MaulikItaliya/Mixed-Signal-Board/Validation/DRC_Report.pdf

### Design Rules Verification Report

Filename : D:\Mixed_design_board\My data\Mixed_Design_Board.PcbDoc | Warnings 0

### Rule Violations 0

Warnings
Total | 0

Rule Violations
Clearance Constraint (Gap=0.1mm) (All),(All) | 0
Clearance Constraint (Gap=1mm) (InNet('EARTH')),(InNet('GND')) | 0
Clearance Constraint (Gap=1mm) (InNet('EARTH')),(InNet('NetC21_2')) | 0
Short-Circuit Constraint (Allowed=No) (All),(All) | 0
Un-Routed Net Constraint ( (All) ) | 0
Modified Polygon (Allow modified: No), (Allow shelved: No) | 0
Width Constraint (Min=0.1mm) (Max=1mm) (Preferred=0.254mm) (All) | 0
Width Constraint (Min=0.3mm) (Max=1mm) (Preferred=0.3mm) (InNet('GND')) | 0
Width Constraint (Min=0.3mm) (Max=1mm) (Preferred=0.3mm) (InNet('+3V3')) | 0
Routing TopologyRule(Topology=Shortest) (All) | 0
Power Plane Connect Rule(Relief Connect )(Expansion=0.508mm) (Conductor Width=0.254mm) (Air Gap=0.254mm) | 0
Hole Size Constraint (Min=0.025mm) (Max=5mm) (All) | 0
Hole To Hole Clearance (Gap=0.2mm) (All),(All) | 0
Silk to Silk (Clearance=0.1mm) (All),(All) | 0
Net Antennae (Tolerance=0mm) (All) | 0
Height Constraint (Min=0mm) (Max=25.4mm) (Prefered=12.7mm) (All) | 0
Total | 0
Sunday 11 Oct 2026 1:04:21 PM | Page 1 of 1
