MaulikItaliya/Mixed-Signal-Board/Documentation/PCB/Bottom_3D_View_PCB.PDF

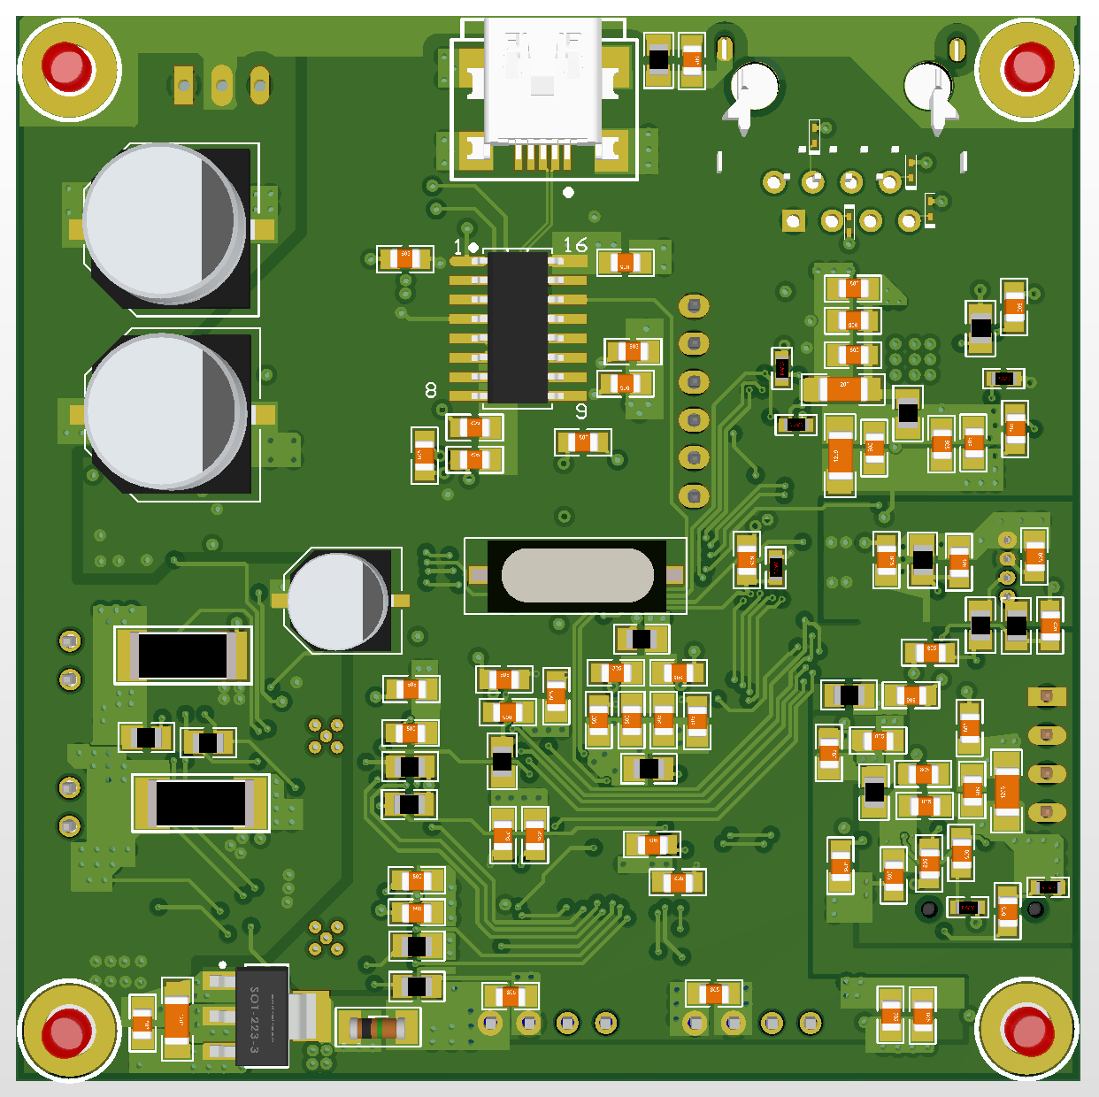
[picture p6: page 1]
