MaulikItaliya/Mixed-Signal-Board/Documentation/PCB/Top_View_3D_PCB.PDF

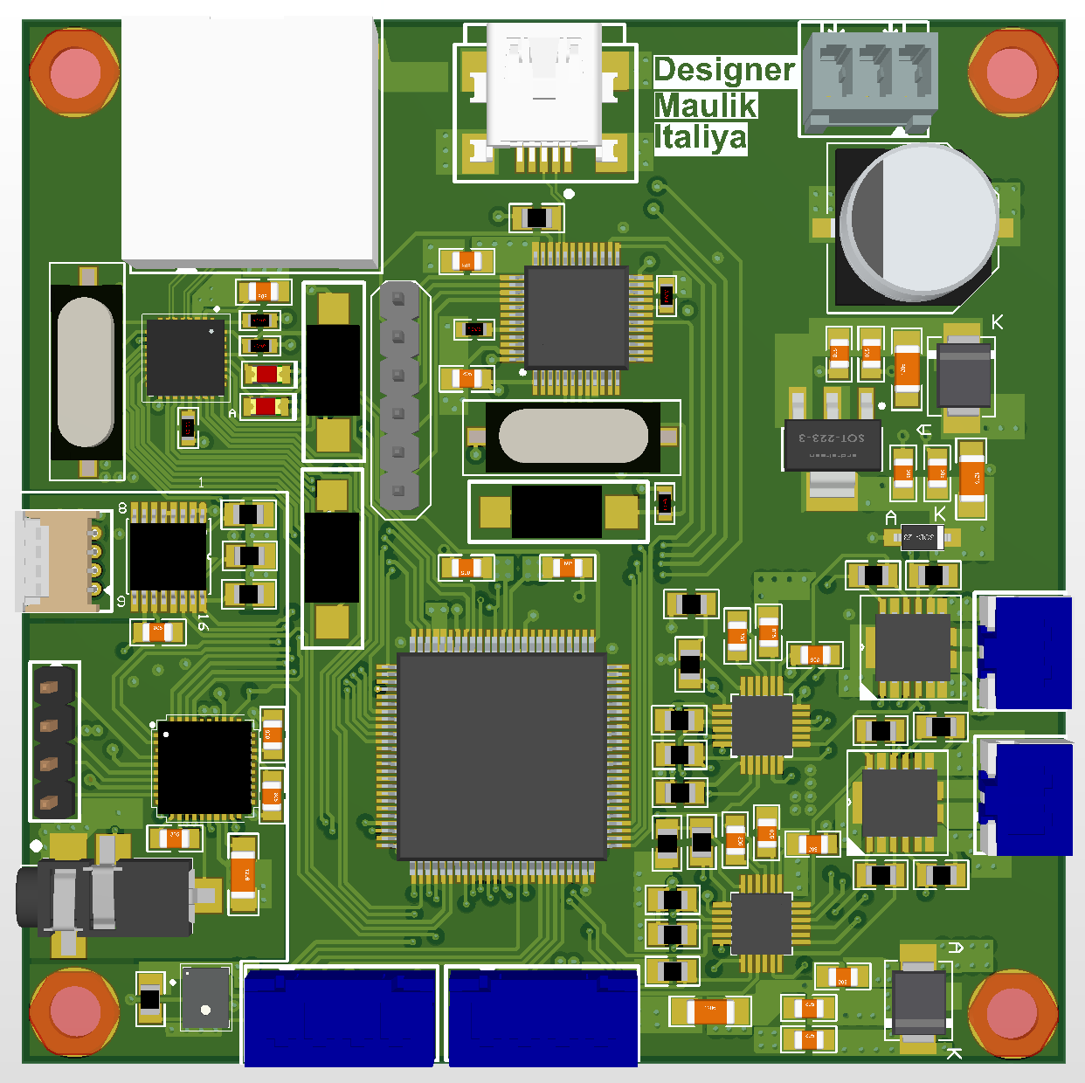
[picture p7: page 1]
