MaulikItaliya/Mixed-Signal-Board/BOM/Mixed_Design_Board_DigiKey__BOM.xlsx

Sheet: DigiKey BOM
MIXED DESIGN BOARD — DIGIKEY BOM
Designator | Value / Component | Quantity | Description | Package | Manufacturer | Manufacturer Part Number | DigiKey Part Number
C1, C59 | 4.7uF | 2 | 4.7µF ±10% 50V Ceramic Capacitor X5R 0805 (2012 Metric) | 0805 | Yageo | CC0805KKX5R9BB475 | 13-CC0805KKX5R9BB475CT-ND
C2, C3, C4, C9, C22, C25, C58, C72, C75 | 0.1uF | 9 | 0.1µF ±10% 50V Ceramic Capacitor X7R 0805 (2012 Metric) | 0805 | Samsung | CL21B104KBFNNNE | 1276-1180-1-ND
C5, C6, C55, C56 | 30pF | 4 | ±10% 50V Ceramic Capacitor C0G, NP0 0805 (2012 Metric) | 0805 | KEMET | C0805C300K5GACTU | 399-C0805C300K5GACTUCT-ND
C7, C12, C18, C23, C26, C27, C36, C40, C41, C42, C51, C52, C67, C68, C73, C76, C77, C82, C85, C88, C91 | 1uF | 21 | 1µF ±5% 50V Ceramic Capacitor X7R 0805 (2012 Metric) | 0805 | Samsung | CL21B105KAFNNNE | 1276-CL21B105KAFNNNECT-ND
C8, C14, C16, C21, C32, C33 | 10nF | 6 | 10000pF ±10% 50V Ceramic Capacitor X7R 0805 (2012 Metric) | 0805 | Samsung | CL21B103KBANNNC | 1276-1015-1-ND
C10 | 2nF | 1 | 2000pF ±10% 50V Ceramic Capacitor X7R 0805 (2012 Metric) | 0805 | Samsung Electro-Mechanics | CL21B202KBANNNC | 1276-CL21B202KBANNNCCT-ND
C11, C19, C45, C50, C83, C84, C89, C90 | 10uF | 8 | 10µF ±10% 50V Ceramic Capacitor X7R 1206 (3216 Metric) | 1206 | KEMET | C3216X7R1H106K160AB | 445-1445-1-ND
C13, C17, C28, C29, C30, C31, C34, C35, C37, C39, C44, C46, C47, C53, C54, C57, C60, C61, C62, C63, C64, C69, C70, C71, C81, C86, C87, C92 | 0.1uF | 28 | 0.1µF ±5% 50V Ceramic Capacitor X7R 0805 (2012 Metric) | 0805 | AVX Corporation | CL21B104KBFNNNE | 1276-1180-1-ND
C15, C20 | 20pF | 2 | ±10% 50V Ceramic Capacitor C0G, NP0 0805 (2012 Metric) | 0805 | AVX Corporation | 08055A200KAT2A | 478-08055A200KAT2ACT-ND
C24 | 100uF | 1 | 100µF 25V Aluminum Electrolytic Capacitors Radial, Can - SMD 1000 Hrs @ 105°C | Radial-SMD | Nichicon | UCM1E101MCL1GS | 493-14926-1-ND
C38, C43 | 22nF | 2 | 0.022µF ±10% 50V Ceramic Capacitor X7R 0805 (2012 Metric) | 0805 | Samsung Electro-Mechanics | CL21B223KBANNNC | 1276-1081-1-ND
C48, C49 | 150pF | 2 | 50V 150pF X7R ±10% 0805 Multilayer Ceramic Capacitors MLCC - SMD/SMT ROHS | 0805 | Yageo | CC0805KRX7R9BB151 | 13-CC0805KRX7R9BB151CT-ND
C65, C66 | 2.2uF | 2 | 2.2µF ±10% 25V Ceramic Capacitor X7R 0805 (2012 Metric) | 0805 | KEMET | C0805C225K3RACTU | 399-C0805C225K3RACTUCT-ND
C78, C79, C80 | 100uF | 3 | 100µF 50V Aluminum Polymer Capacitor Radial, Can - SMD 28mOhm 4000 Hrs @ 125°C | Radial-SMD | Nichicon | UHW1H101MPD | 493-XXXX-ND
D1, D2, D3, D4 | ESD3V3D9-TP | 4 | TVS DIODE 3.3V 8.8V SOD923 | SOD923 | Micro Commercial Co | ESD3V3D9-TP | ESD3V3D9-TPCT-ND
D5, D7 | MBRS130LT3G | 2 | Diode Schottky 30V 2A Surface Mount SMB | SMB | ON Semiconductor | MBRS130LT3G | MBRS130LT3GOSCT-ND
D6 | BZT52C3V3-7-F | 1 | Zener Diode 3.3V 500mW ±6% Surface Mount SOD-123 | SOD-123 | Diodes Incorporated | BZT52C3V3-7-F | BZT52C3V3-FDICT-ND
D8 | 3.3V ZENER | 1 | Zener Diode 3.3V 500mW ±5% Surface Mount LLDS; MiniMelf | SOD-80 | onsemi | MMSZ4684T1G | MMSZ4684T1GOSCT-ND
DS1, DS2 | RED LED | 2 | Red 631nm LED Indication - Discrete 2V 0805 (2012 Metric) | 0805 | Lite-On | LTST-C170KRKT | 160-1414-1-ND
FB1, FB2, FB3, FB4 | 1K | 4 | 1 kOhms @ 100MHz 1 Power Line Ferrite Bead 0805 (2012 Metric) 1.6A | 0805 | Laird | MI0805K400R-10 | 240-2398-1-ND
J1 | Bergstrip 2.54mm | 1 | 6 Pins, 1 Row 2.54mm Pitch, Straight bergstrip, Female | TH-CON | Molex | 22-05-7061 | WM4200-ND
J2, J5 | USB2.0 MINI B | 2 | USB - mini B USB 2.0 Receptacle Connector 5 Position Surface Mount, Right Angle | USB-MINI-B | EDAC | 690-005-299-043 | EDAC-690-005-299-043-ND
J3 | RJ45 LAN | 1 | 8 Pins, 2 Row 2.54mm Pitch, right angle Connector, male | TH-CON | Assmann WSW | A-2004-2-4-LP-N-R | AE9919-ND
J4, J10 | B2B-XH-A(LF)(SN) | 2 | 2 Pins, 1 Row 2.54mm Pitch, Straight Connector, male | TH-CON | JST | B2B-XH-A | 455-B2B-XH-A-ND
J6 | 1.25MM Spade 4PIN | 1 | 4 Pins, 1 Row 1.25mm Pitch, right angle Connector, male | TH-CON | JST | SM04B-SRSS-TB | 455-1804-1-ND
J7 | 4X1 STEREO | 1 | 2.50mm (0.094", 3/32", Sub Mini, Miniature) - Headphone Phone Jack Stereo (4 Conductor, TRRS) Connector Solder | SMD | CUI Devices | SJ-43514-SMT-TR | CP-43514SJCT-ND
J8, J9 | B4B-XH-A(LF)(SN) | 2 | 4 Pins, 1 Row 2.54mm Pitch, straight Connector, male | TH-CON | JST | B4B-XH-A | 455-B4B-XH-A-ND
J11 | Terminal Block 2.5mm | 1 | 3 Pins, 1 Row 2.54mm Pitch, straight Connector, male | TH-CON | Phoenix Contact | 1725656 | 277-1725656-ND
J12 | 4X1 BERG STRIP | 1 | 4 Pins, 1 Row 2.54mm Pitch, Straight bergstrip, Male | TH-CON | Würth Elektronik | 61300411121 | 732-5310-ND
MH1, MH2, MH3, MH4 | Mounting Hole | 4 | Mounting Hole | TH | NA | Not applicable — PCB mounting hole | Not applicable — PCB feature
Q1, Q2 | DMHT6016LFJ-13 | 2 | Mosfet Array 4 N-Channel 14.8A (Ta) Surface Mount V-DFN5045-12 | DFN5045-12 | ON Semiconductor | DMHT6016LFJ-13 | DMHT6016LFJ-13CT-ND
R1, R4 | 100K | 2 | 100 kOhms ±1% 0.1W, 1/10W Chip Resistor 0603 (1608 Metric) Automotive AEC-Q200 Thick Film | 0603 | Stackpole Electronics | RMCF0603FT100K | RMCF0603FT100KCT-ND
R2 | 1.5K | 1 | 1.5 kOhms ±1% 0.125W, 1/8W Chip Resistor 0805 (2012 Metric) Thick Film | 0805 | TE Connectivity | CRGH0805F1K5 | A126395CT-ND
R3, R7, R8, R9, R10, R36 | 10K | 6 | 10 kOhms ±1% 0.1W, 1/10W Chip Resistor 0603 (1608 Metric) Automotive AEC-Q200 Thick Film | 0603 | Walsin | WR06X1002FTL | 1292-WR06X1002FTLCT-ND
R5, R6 | 3K3 | 2 | 3.3 kOhms ±1% 0.1W, 1/10W Chip Resistor 0603 (1608 Metric) Automotive AEC-Q200 Thick Film | 0603 | Yageo | RC0603FR-073K3L | 311-3.30KHRCT-ND
R11 | 6.49K | 1 | 6.49 kOhms ±1% 0.125W, 1/8W Chip Resistor 0805 (2012 Metric) Moisture Resistant Thick Film | 0805 | Stackpole Electronics | RMCF0805FT6K49 | RMCF0805FT6K49CT-ND
R12 | 1M | 1 | 1 MOhms ±1% 0.125W, 1/8W Chip Resistor 0805 (2012 Metric) Automotive AEC-Q200 Thick Film | 0805 | Walsin | WR08X1004FTL | 1292-WR08X1004FTLCT-ND
R13, R37 | 2K | 2 | 2 kOhms ±1% 0.125W, 1/8W Chip Resistor 0805 (2012 Metric) Moisture Resistant Thick Film | 0805 | TE Connectivity | CRGH0805F2K0 | A126402CT-ND
R14, R38 | 3.3K | 2 | 3.3 kOhms ±1% 0.125W, 1/8W Chip Resistor 0805 (2012 Metric) Thick Film | 0805 | Panasonic | ERJ-6ENF3301V | P3.30KACT-ND
R15, R16, R17, R18, R21, R22, R23, R24, R25, R26, R31, R33, R39, R40, R41, R42, R45, R46, R47, R48 | 10K | 20 | 10 kOhms ±1% 0.125W, 1/8W Chip Resistor 0805 (2012 Metric) Automotive AEC-Q200 Thick Film | 0805 | Vishay | CRCW080510K0FKEA | 541-10.0KACT-ND
R19, R43 | 33K | 2 | Thick Film Resistors - SMD 33KOhms 1/8W 150V33 kOhms ±1% 0.125W, 1/8W Chip Resistor 0805 (2012 Metric) Thick Film | 0805 | Vishay | CRCW080533K0FKEA | 541-33.0KACT-ND
R20, R44 | 50mOHM | 2 | 50 mOhms ±1% 2W Chip Resistor 2512 (6432 Metric) Automotive AEC-Q200, Current Sense, Moisture Resistant Metal Element | 2512 | Yageo | PA2512FKF7W0R050E | YAG3594CT-ND
R27 | 100K | 1 | 100 kOhms ±1% 0.125W, 1/8W Chip Resistor 0805 (2012 Metric) Automotive AEC-Q200 Thick Film | 0805 | Walsin | WR08X1003FTL | 1292-WR08X1003FTLCT-ND
R28, R29 | 1K | 2 | 1 kOhms ±1% 0.125W, 1/8W Chip Resistor 0805 (2012 Metric) Moisture Resistant Thick Film | 0805 | Walsin | WR08X1001FTL | 1292-WR08X1001FTLCT-ND
R30, R32 | 51.1R | 2 | 51.1 Ohms ±1% 0.1W, 1/10W Chip Resistor 0603 (1608 Metric) Thick Film | 0603 | Vishay Dale | CRCW060351R1FKEA | 541-51.1HCT-ND
R34, R35 | 100R | 2 | 100 Ohms ±1% 0.125W, 1/8W Chip Resistor 0805 (2012 Metric) Automotive AEC-Q200, Pulse Withstanding Thick Film | 0805 | Walsin | WR08X1000FTL | 1292-WR08X1000FTLCT-ND
SW1, SW2, SW3 | TACTILE SWITCH | 3 | Tactile Switch SPST-NO Top Actuated Surface Mount | SMD | C&K | KMR2 | CKN10298CT-ND
U1 | STM32F103C8T6 | 1 | ARM® Cortex®-M3 STM32F1 Microcontroller IC 32-Bit 72MHz 64KB (64K x 8) FLASH 48-LQFP (7x7) | LQFP48 | STMicroelectronics | STM32F103C8T6 | 497-6063-ND
U2 | DP83826IRHBR | 1 | Ethernet ICs Low latency 10/100-Mbps PHY, MII interface and enhanced mode with an industrial temperature range 32-VQFN -40 to 85 | 32-VQFN | Texas Instruments | DP83826IRHBR | 296-DP83826IRHBRCT-ND
U3, U9 | DRV8701ERGET | 2 | Motor Driver Power MOSFET Parallel 24-VQFN (4x4) | VFQFN24 | Texas Instruments | DRV8701ERGET | 296-DRV8701ERGETCT-ND
U4 | CH340C | 1 | USB Bridge, USB to UART USB 2.0 UART Interface | SOIC16 | Olimex | CH340C | CH340C-ND
U5 | ADS122C04IPW | 1 | 24 Bit Analog to Digital Converter 4 Input 1 Sigma-Delta 16-TSSOP | TSSOP16 | Texas Instruments | ADS122C04IPW | 296-49069-ND
U6 | CS43L22-CNZ | 1 | Audio D/A Converter ICs Low Power Stereo DAC w/ClassD Spkr Driver | QFN-40 | Cirrus Logic | CS43L22-CNZ | 598-1650-ND
U7 | IMP34DT05TR | 1 | MEMS Microphones AUTO & INDUSTRIAL SENSORS | HCLGA-4 | STMicroelectronics | IMP34DT05TR | 497-18183-1-ND
U8 | STM32F407VGT6 | 1 | ARM® Cortex®-M4 STM32F4 Microcontroller IC 32-Bit 168MHz 1MB (1M x 8) FLASH 100-LQFP (14x14) | LQFP100 | STMicroelectronics | STM32F407VGT6 | 497-11605-ND
U10, U11 | LD1117S33CTR | 2 | Linear Voltage Regulator IC 1 Output 800mA SOT-223 | SOT223 | STMicroelectronics | LD1117S33CTR | 497-1241-1-ND
X1, X2 | 8Mhz | 2 | 8MHz ±30ppm Crystal 32pF 60 Ohms HC-49/US | SMD/SMT | ECS Inc. | ECS-80-32-5PX-TR | XC1970CT-ND
Y1 | 25Mhz -14mm | 1 | 25MHz ±30ppm Crystal 20pF 30 Ohms HC-49/US | SMD | Fox Electronics | FOXSDLF/250F-20 | 535-FOXSDLF/250F-20CT-ND

Sheet: Pricing Notes
PRICING NOTES
Why unit prices are blank | DigiKey pricing depends on current stock, package/reel choice, order quantity, and live price breaks. I did not invent prices. Enter the current DigiKey Germany price in the Unit Price (EUR) column; line totals and the BOM total calculate automatically.
How to get a reliable quote | Upload the BOM into DigiKey My Lists, confirm each exact DigiKey part number and quantity, then use the quote function to lock pricing. DigiKey says quotes can secure pricing for 30 days.
Engineering check | The current part numbers in the workbook still need validation against the schematic, package, electrical ratings, and live DigiKey listing before purchase.
