MaulikItaliya/Mixed-Signal-Board/Documentation/Schematic/Mixed-Signal-Embedded-Board-Schematic.PDF

JTAG/SWD | STM32F103

## DAC & MIC

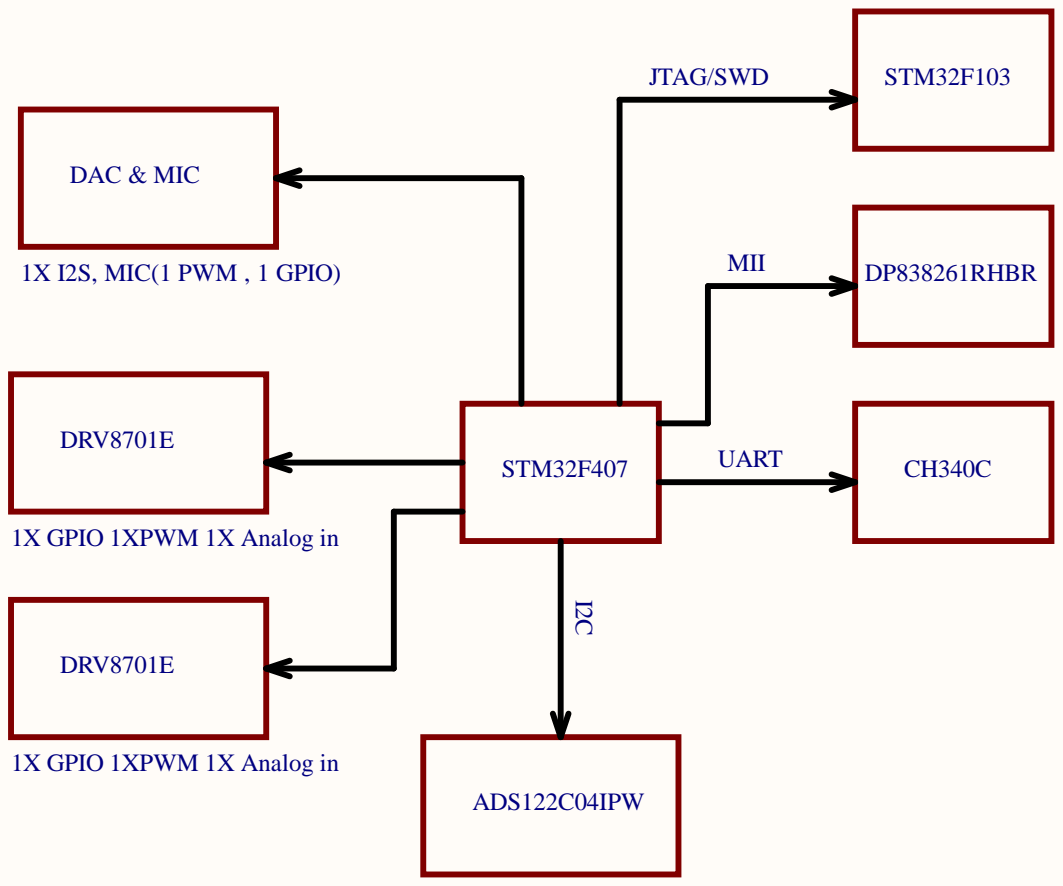
[picture p8: page 1]
File:; STM32F407; DP838261RHBR I; CH340C UART; ADS122C04IPW; DRV8701E

1X I2S, MIC(1 PWM , 1 GPIO)

1X GPIO 1XPWM 1X Analog in

STM32F407 Mixed-Signal Hardware Design
Title

Size: A4 | Number: MSD-001 | Sheet 1 of 11 Revision: V1.0

Date: 06-10-2026 Time: 21:29:24 | | Designer Maulik Italiya

D:\Mixed_design_board\My data\Schematic Blocks.SchDoc

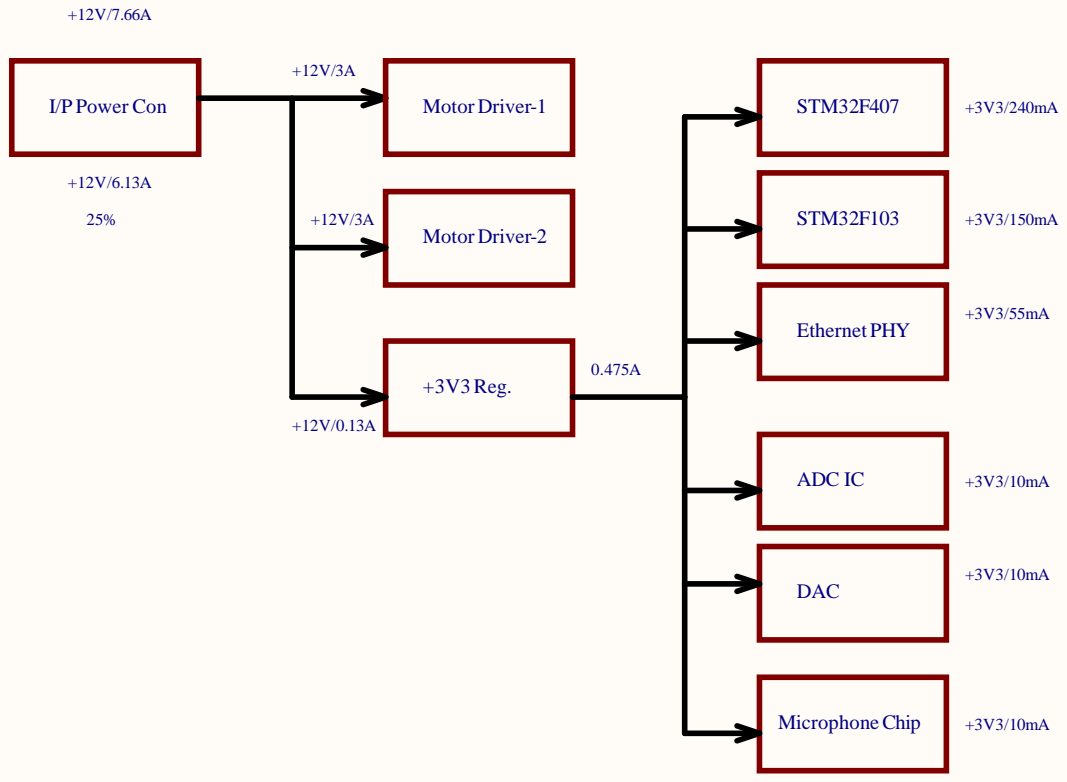
[picture p9: page 2]
File:; I/P Power Con; Motor Driver-1; Motor Driver-2; +3V3Reg.; STM32F407; STM32F103; Ethernet PHY; ADC IC; DAC; MicrophoneChip

STM32F407 Mixed-Signal Hardware Design
Title

Size: A4 | Number: MSD-001 | Sheet 2 of 11 Revision: V1.0

Date: 06-10-2026 Time: 21:29:24 | | Designer Maulik Italiya

D:\Mixed_design_board\My data\Power Budget.SchDoc

R1 100

ST

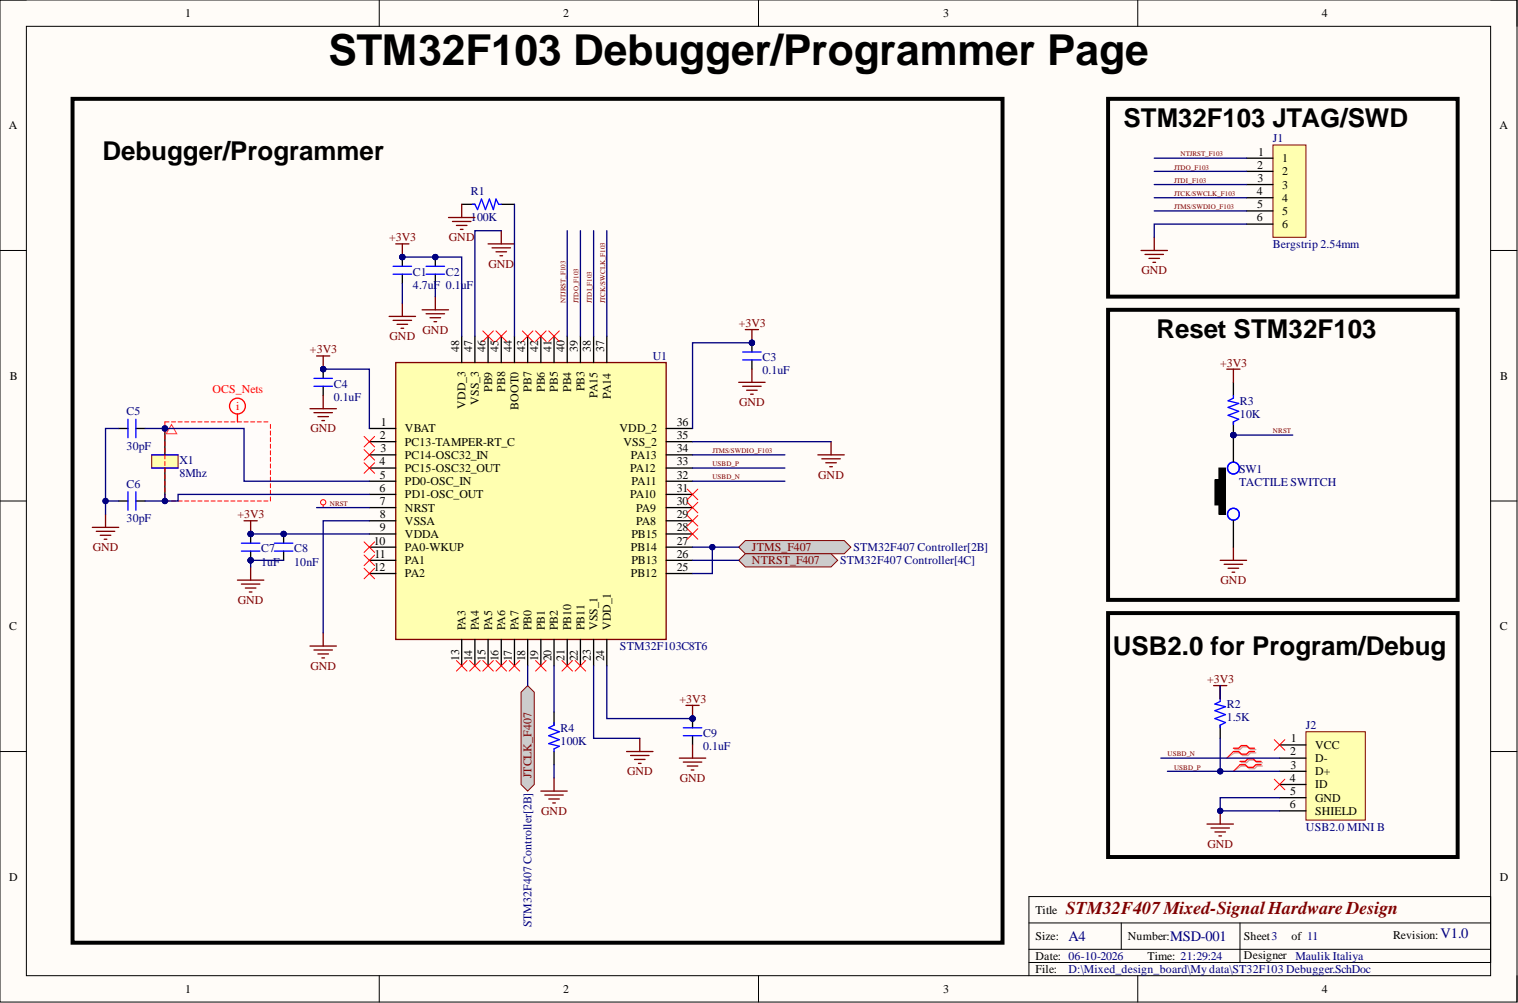
[picture p10: page 3]

Size A | N umb er M SD-1 | Shee t f Rev s V1 .

Dat e -T ime : | | Des er Mau k Ital y a

Ethernet PHY | ETH Reset an

# d Fault LEDs

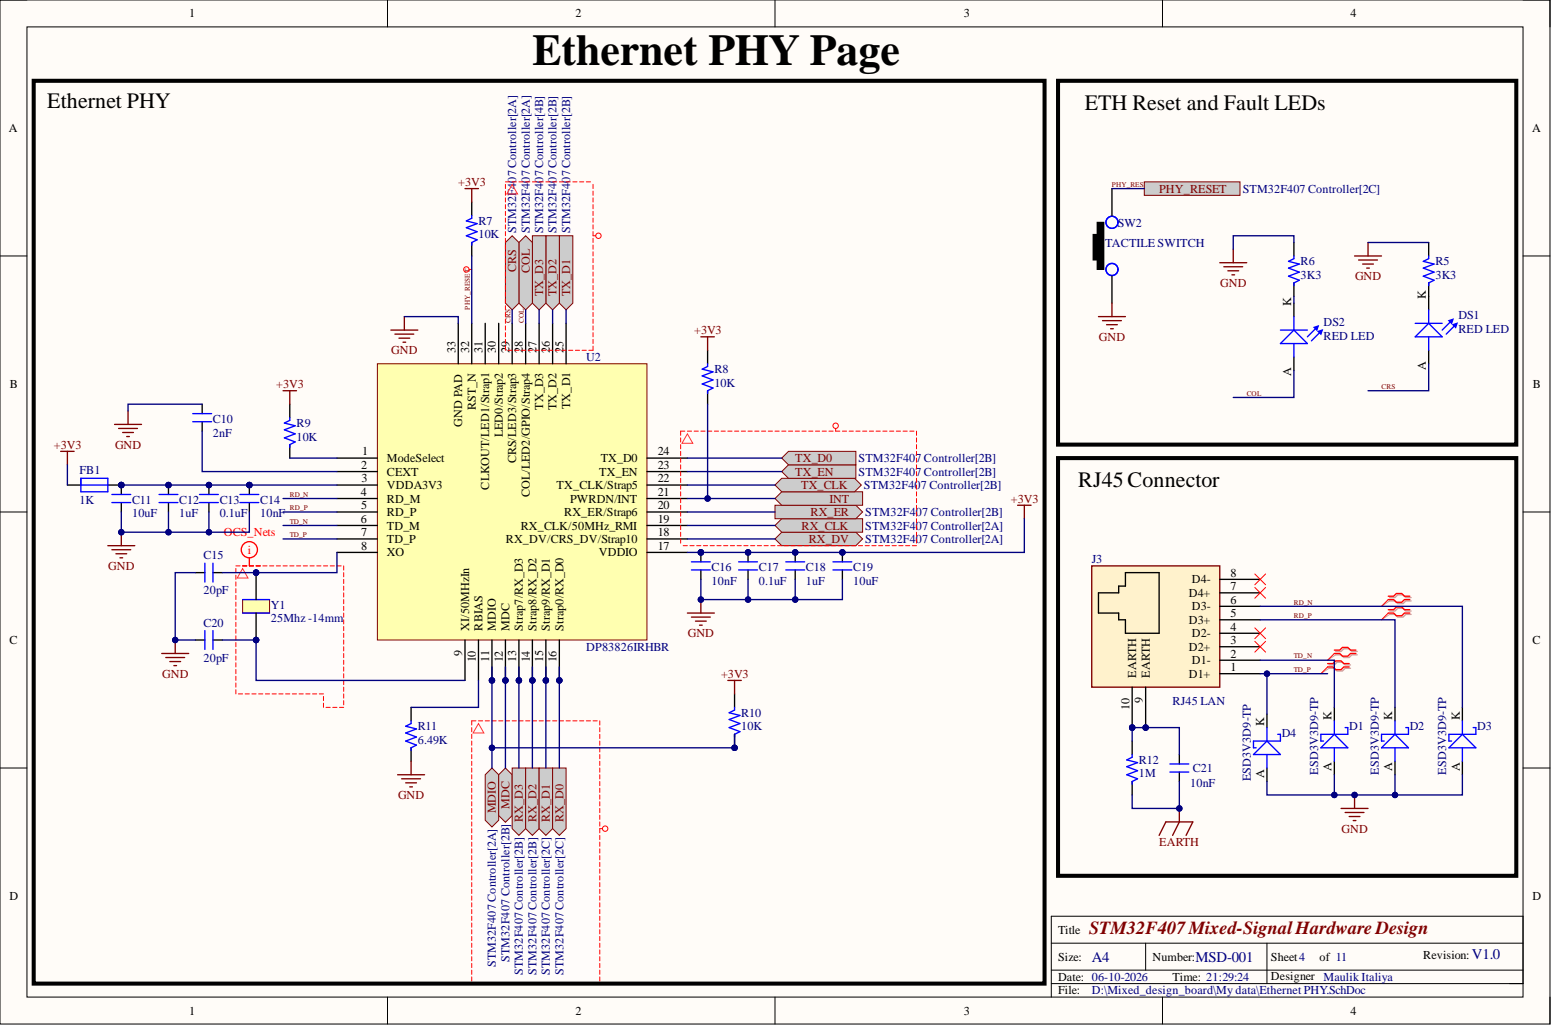
[picture p11: page 4]

# Motor Driver DRV8

7

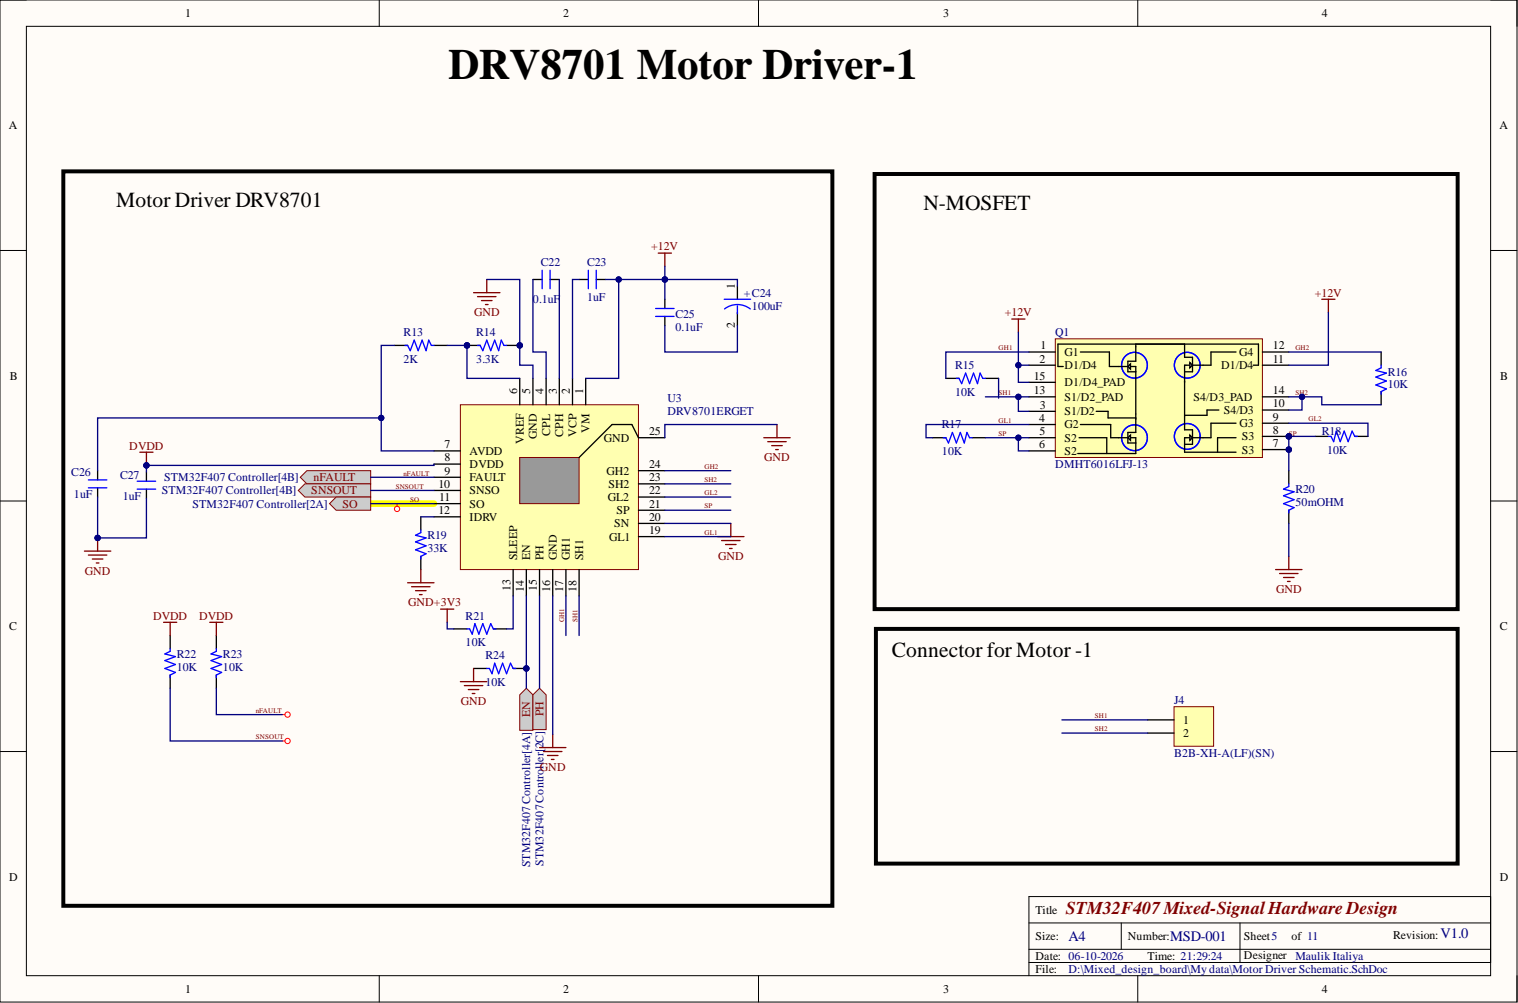
[picture p12: page 5]
STM3 2F4; Mixed-Signal Hardware Desig n; data\Mo; Dri; ver Schemat; SLEEP 13 EN 14 PH 15; GND 16 GH1 17 SH1 18; 24 GND; STM3; tro; ler[; SNSO; ler; nFA; EN STM32F407Controller[4A]; PH STM32F407Controller[2C] G; 4 S1/D2_PAD; DMH; SPGL; N-MOSFET; DRV8701 Motor Driver-1

VM 1 VCP 2 CPH 3 CPL 4 GND 5 VREF 6

nector for Motor -1

CH3

4

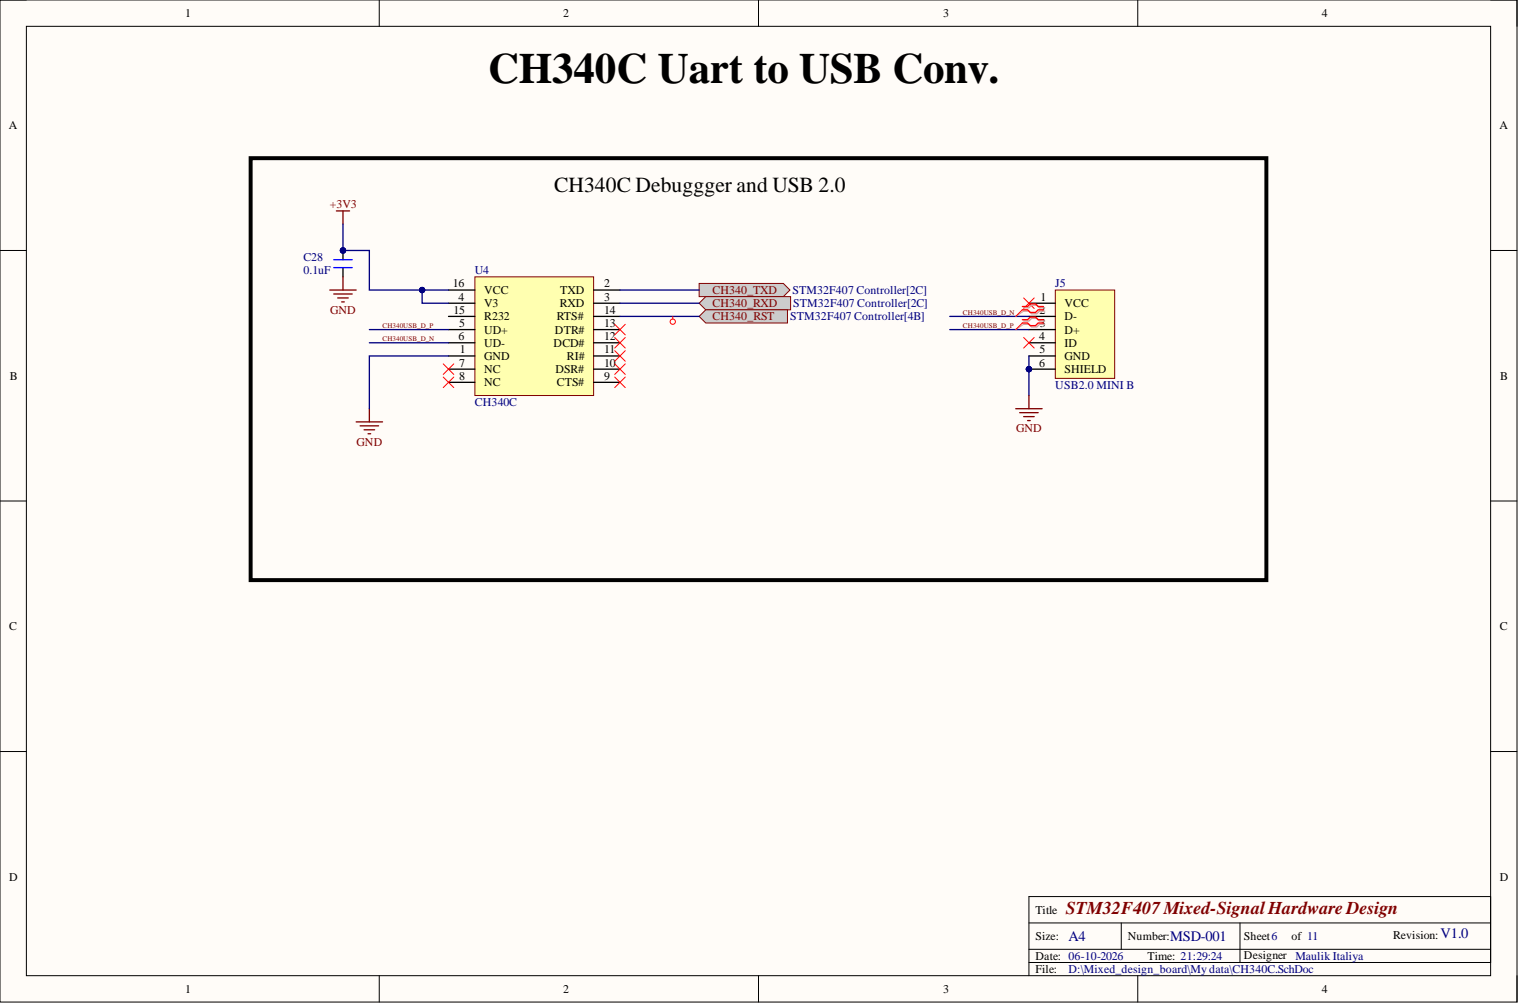
[picture p13: page 6]
STM3 2F4; Mixed-Signal Hardware Desig n; data\CH; DSR#; DCD; RTS#; VCC; H340USB_D_P; H340USB_D; STM3; tro; ler[; SHIE; 5USB2.0 MINI; 0C Deb; ger an; d USB

CH340C Uart to USB Conv

2

# 4 Bit ADC Chip

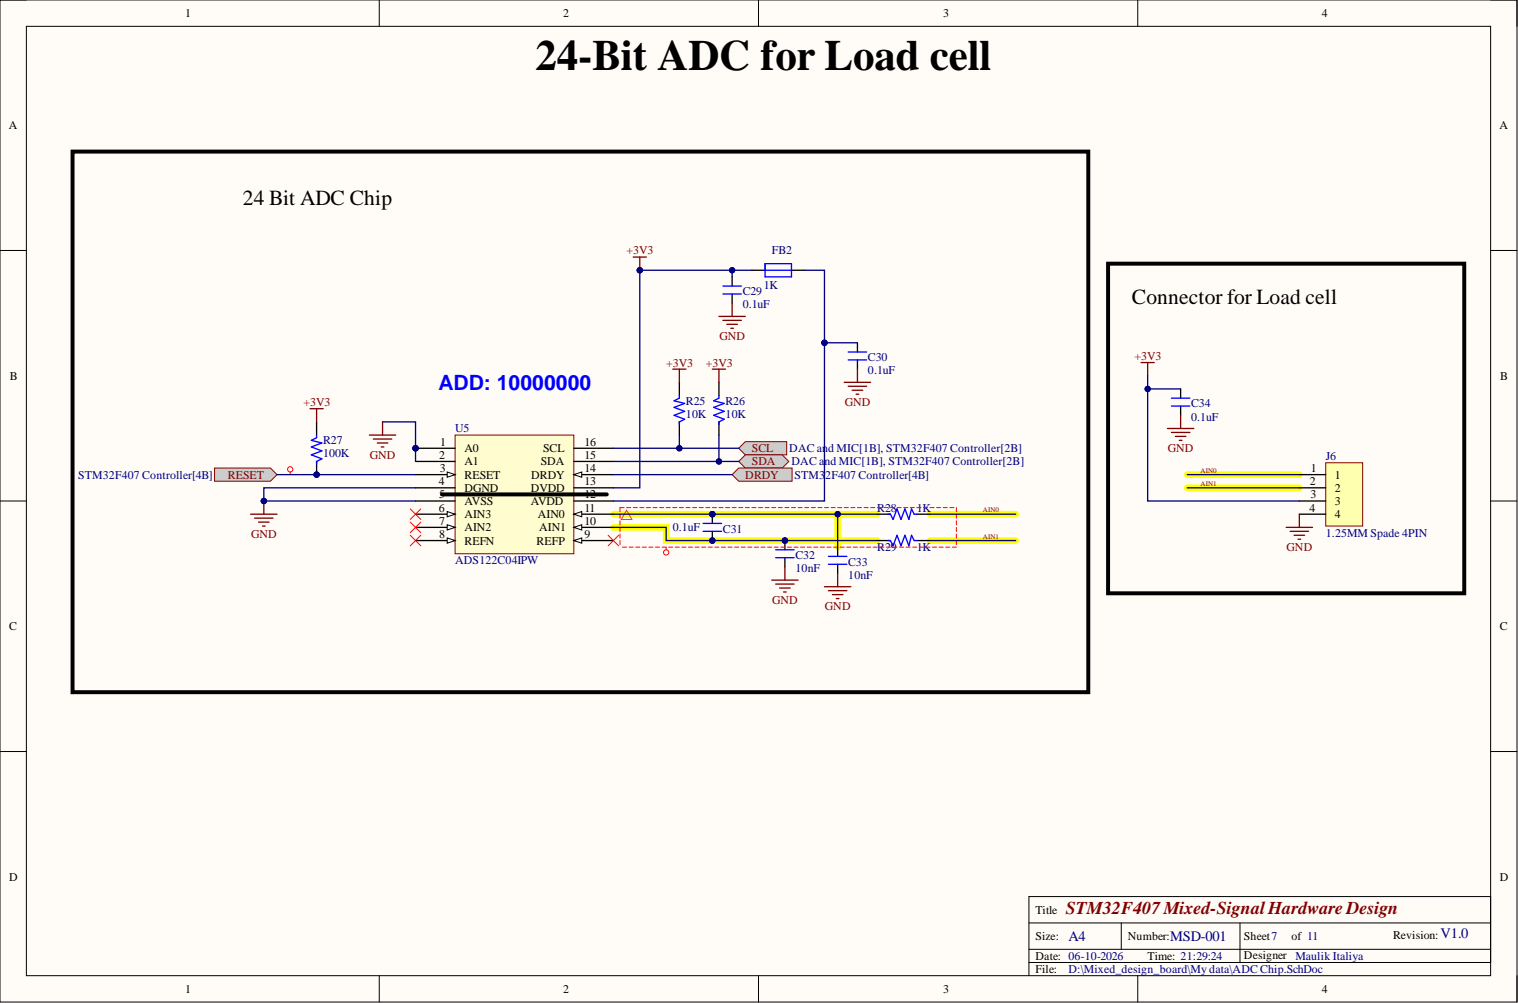
[picture p14: page 7]
STM3 2F4; Mixed-Signal Hardware Desig n; data\; RESE; AIN; REFP; DRD; 4 SDA; 15 SCL; IPW; STM3; tro; ler[; SCL; d MIC[1B], STM3; ler[2B]; 5MM Spade; 4PIN; ADD: 10000000; 24-Bit ADC

for Load cell

nector for Load cell

# ADD: 10010100

# DAC For Stereo

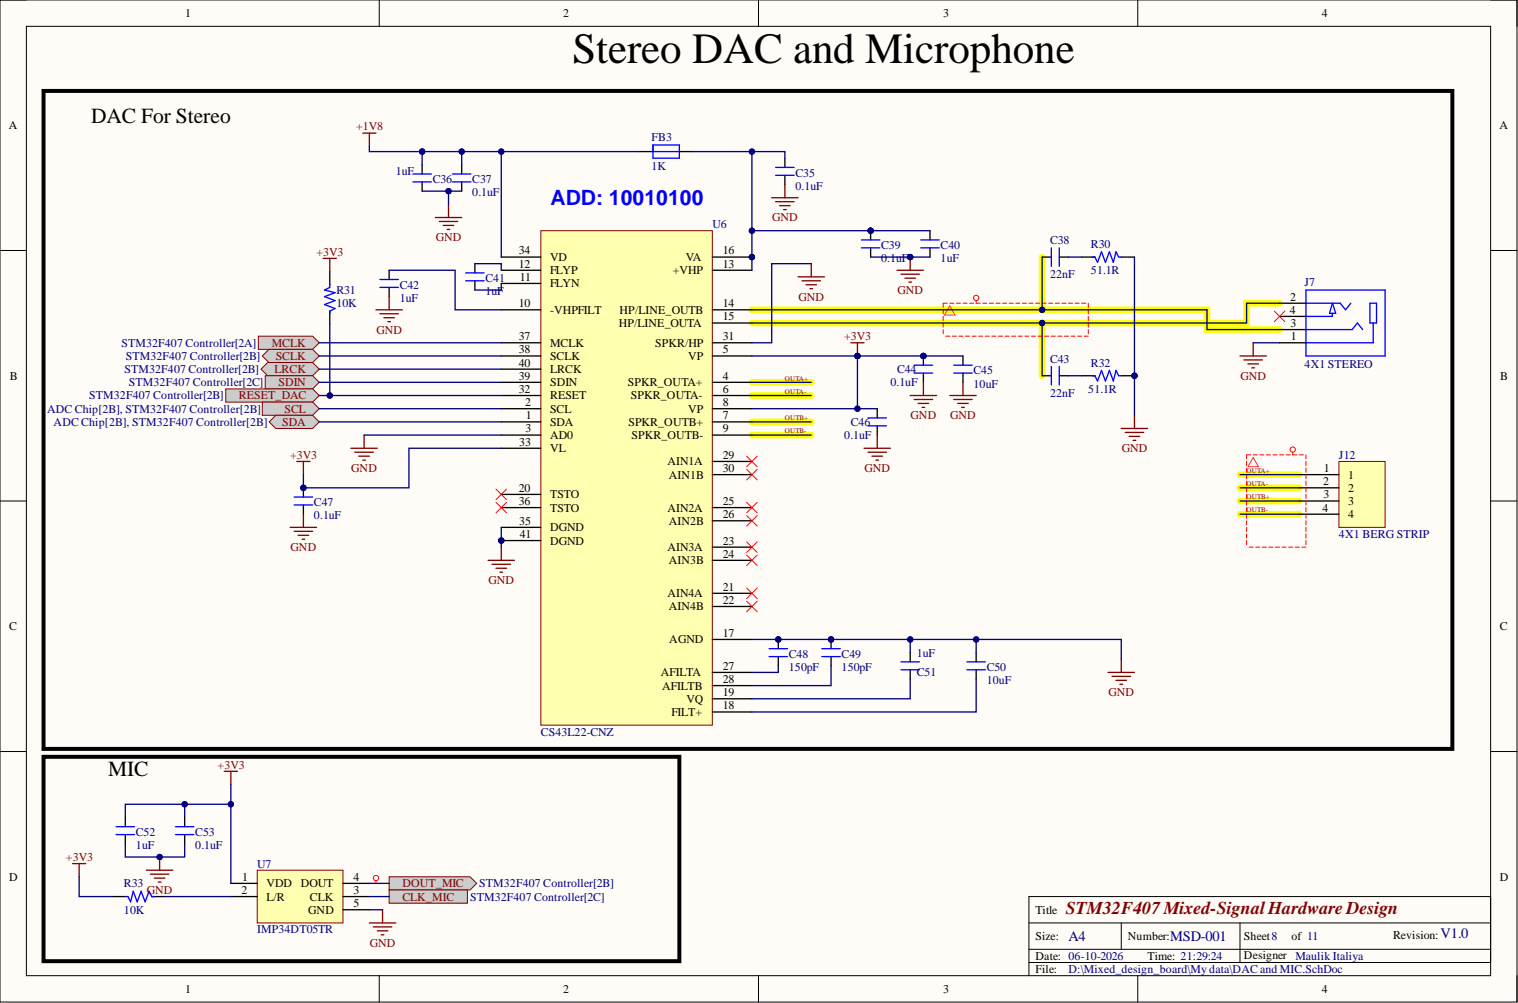
[picture p15: page 8]

Stereo DAC and Microphone

STM32F407 Mixed-Signal Hardware Design
Title

Size: A4 | Number: MSD-001 | Sheet 8 of 11 Revision: V1.0

Date: 06-10-2026 Time: 21:29:24 | | Designer Maulik Italiya

D:\Mixed_design_board\My data\DAC and MIC.SchDoc

8 PE8 | 39 PE9 | 40 PE10 | 41 PE11 | 42 PE12 | 43 PE13 | 44 PE14 | 45 PE15 | 46

# STM3

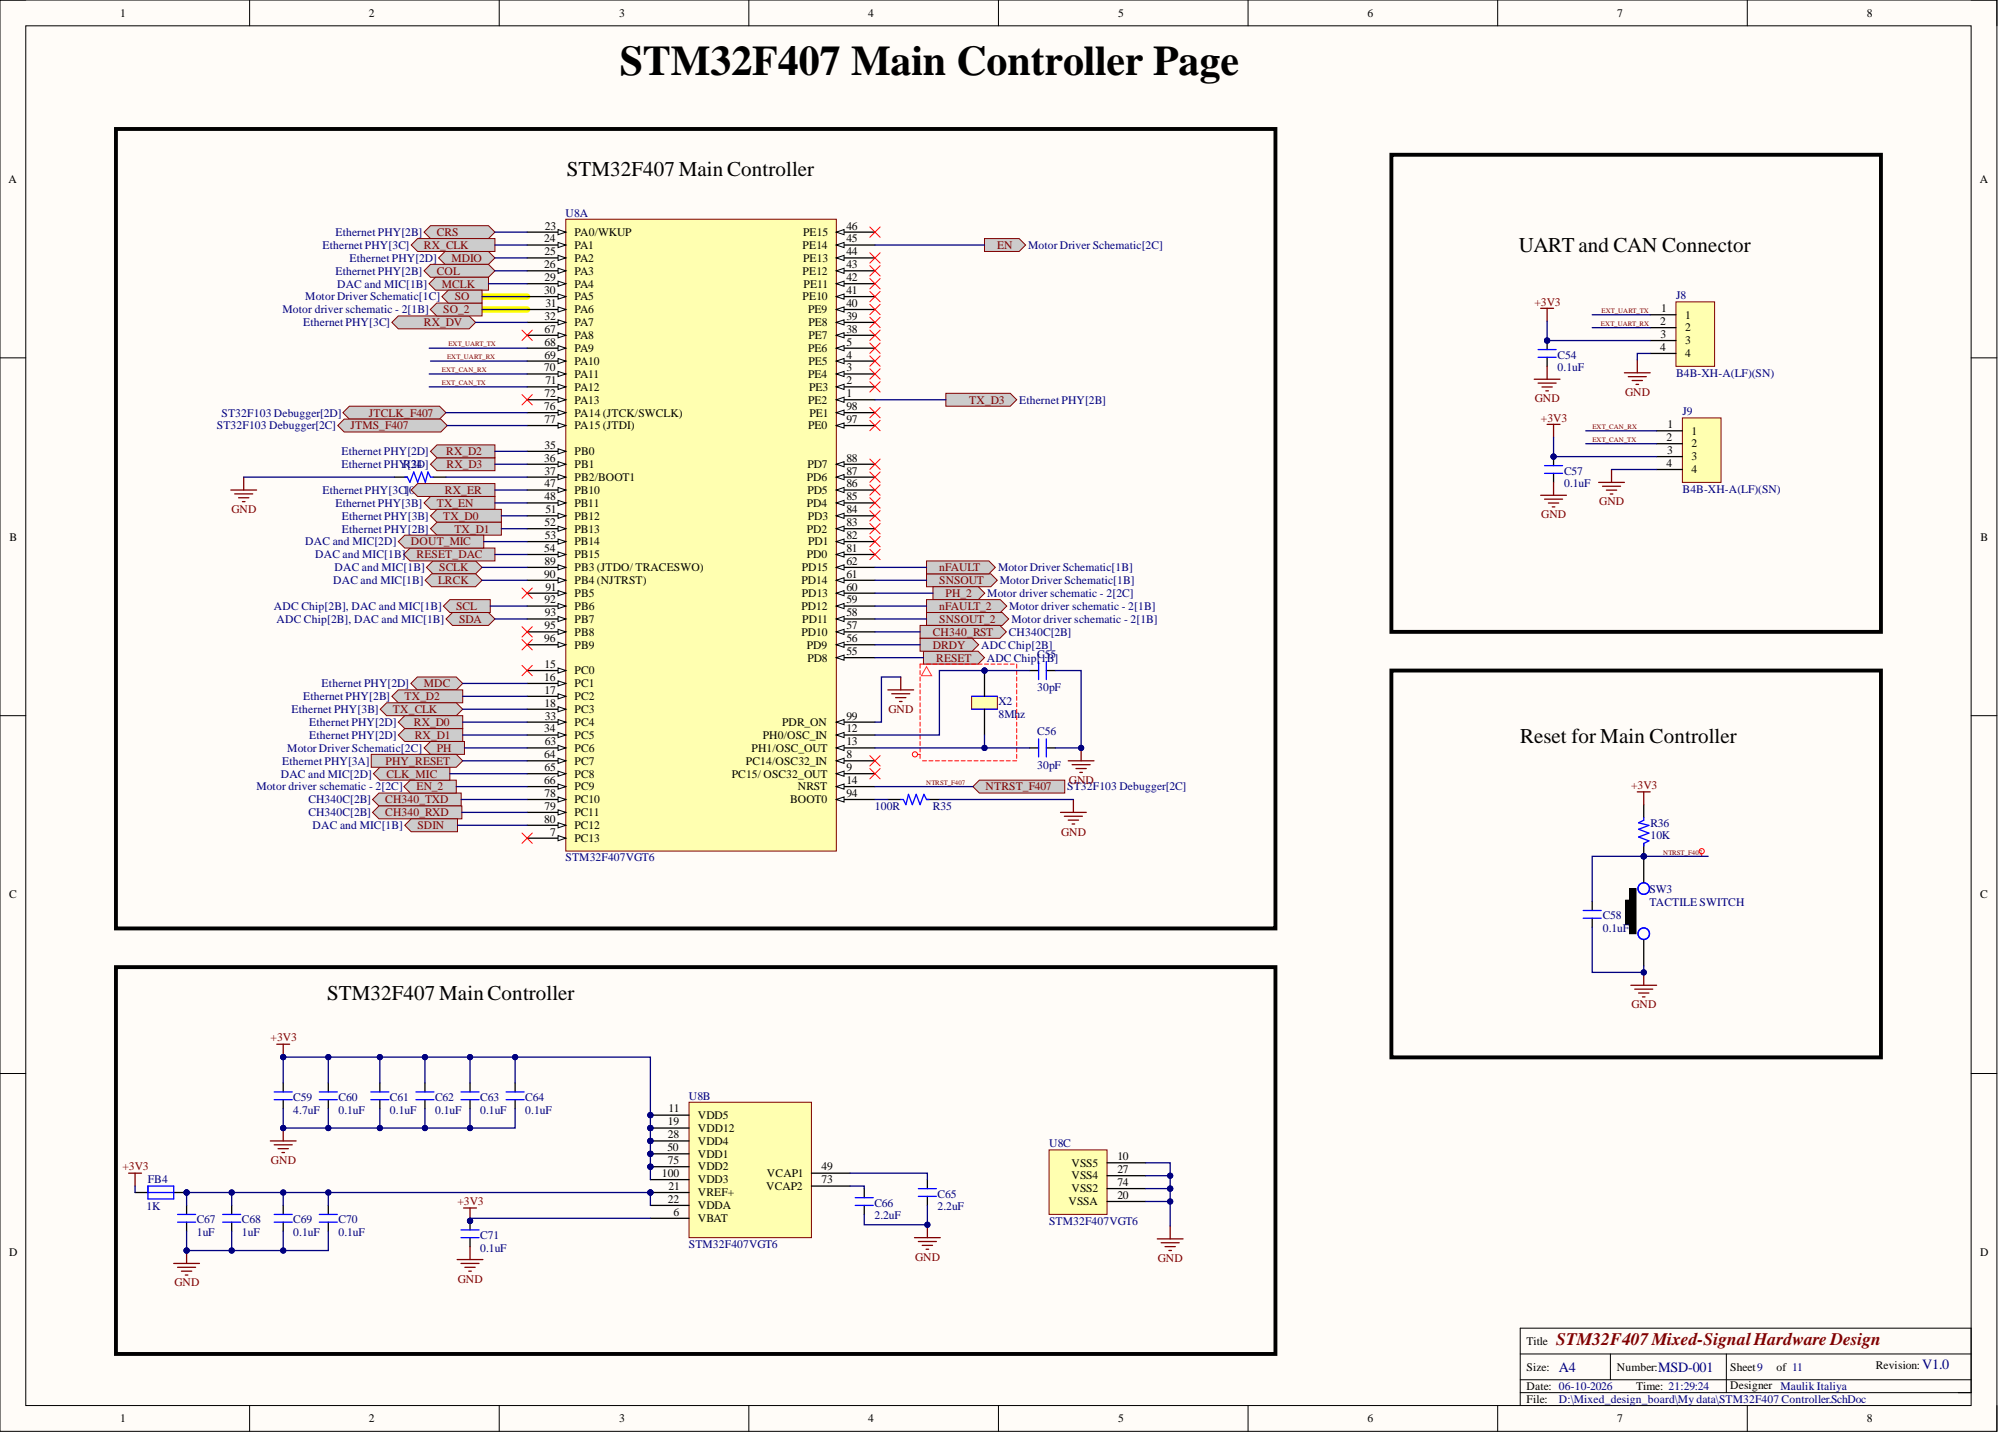
[picture p16: page 9]
STM3 2F4; Mixed-Signal Hardware Desig; data\STM3; tro; OSC3; OSC_; NRS; TCK; /SWCL; TRACESW; TRST; PDR_; STM3; VREF+; VCA; VBAT; VSS; Deb; ger[; TCL; TMS_F4; 3 TACTIL; E SWITCH; TRST_F407; hernet PH; CRS; d MIC[1B]; SCL; LRCK; MCL; Dri; ver Schemat; dri; ver; schemat; d MIC[2; _MIC; SNSO; RESE; DRD; d MIC[1B] RESE; 7 Main Co; ntrolle; UAR; d CAN Co; necto; ntroller

STM32F407 Main Controller Page

Reset for Main Co

# Motor Driver DRV8

7

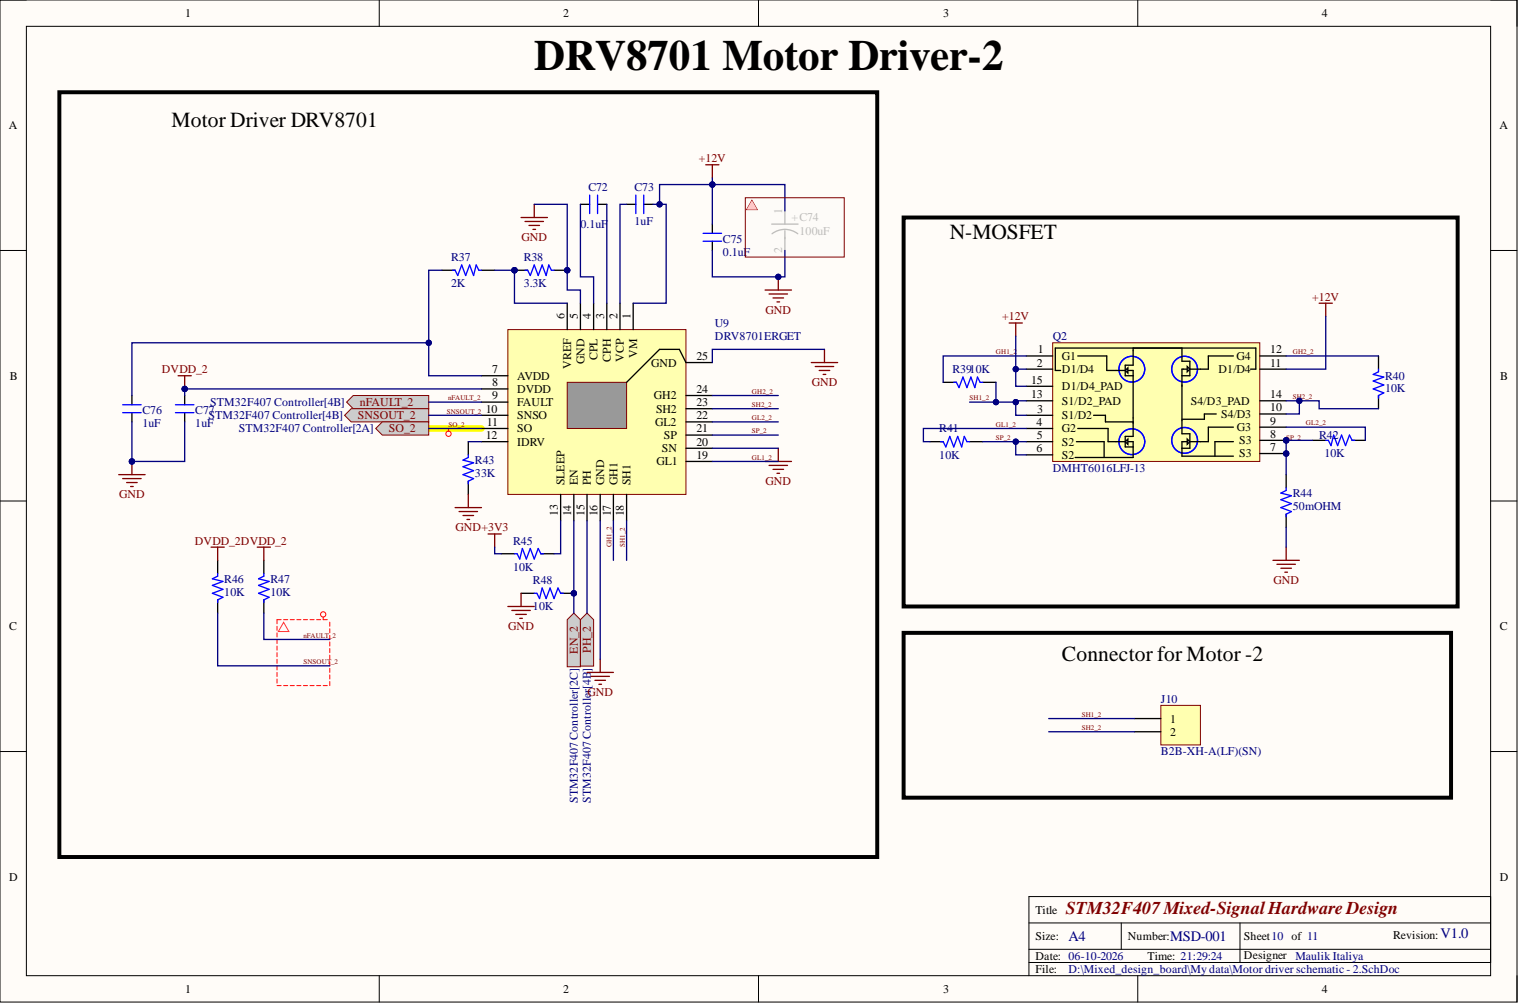
[picture p17: page 10]
STM3 2F4; Mixed-Signal Hardware Desig n; data\Mo; dri; ver; schemat; 2.Sch; SLEEP 13 EN 14 PH 15; GND 16 GH1 17 SH1 18; 24 GND; STM3; tro; ler[; SNSO; ler; nFA; 2 STM32F407Controller[2C]; 2 STM32F407 Controller[4B] G; 4 S1/D2_PAD; DMH; N-MOSFET; DRV8701 Motor Driver-2

VM 1 VCP 2 CPH 3 CPL 4 GND 5 VREF 6

nector for Motor -2

# I/P Power Co

n

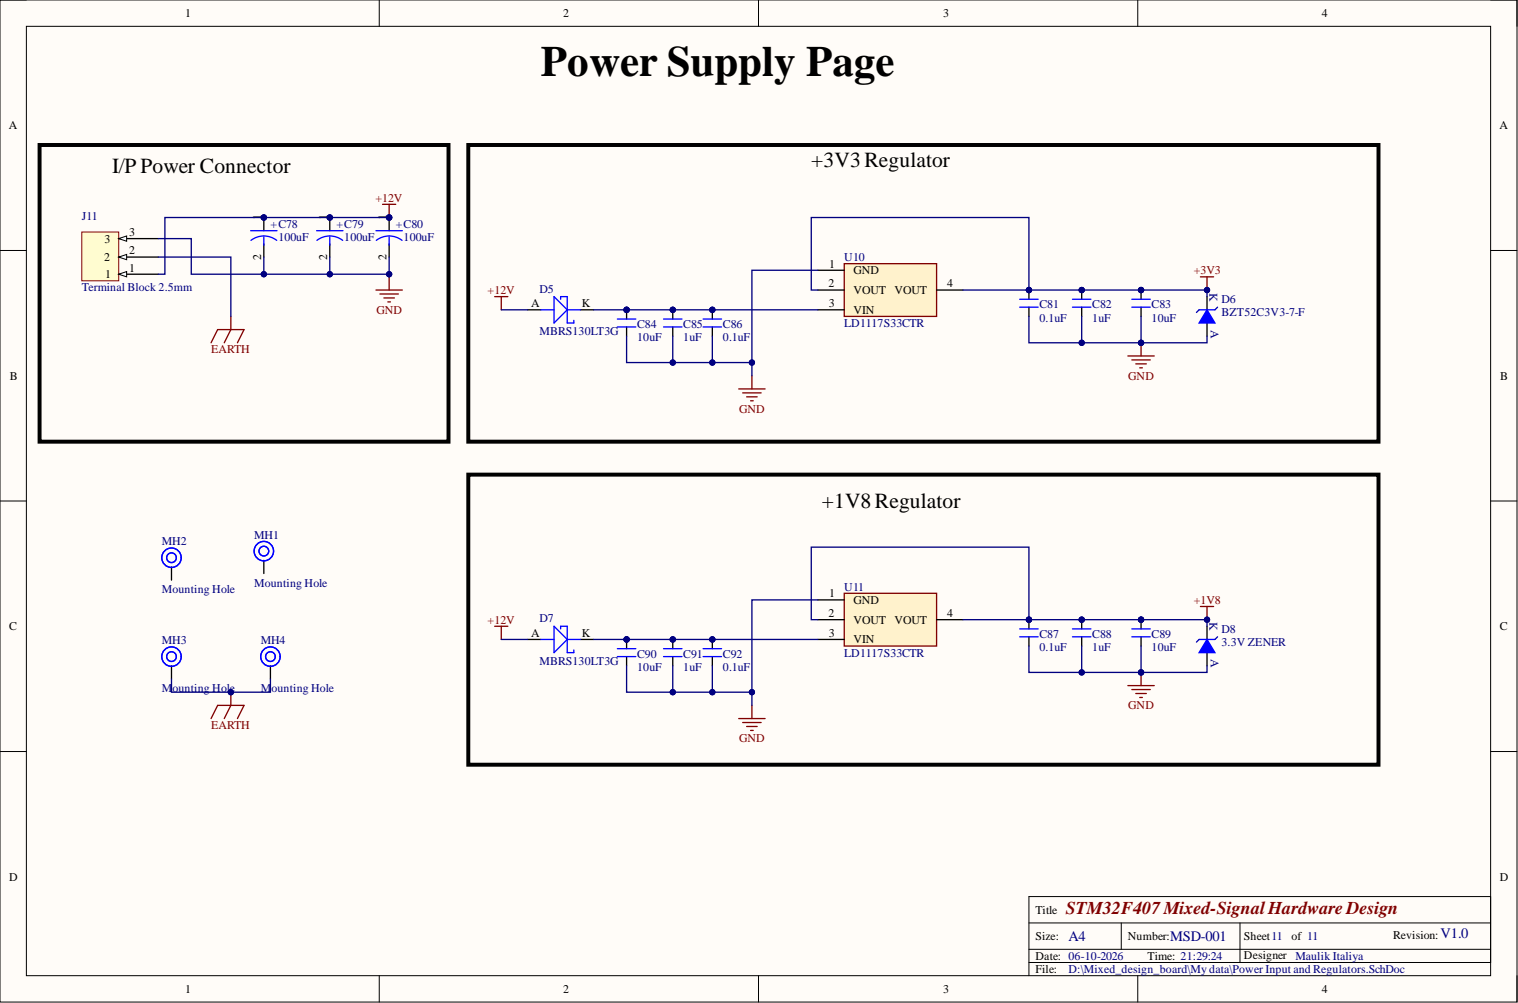
[picture p18: page 11]
STM3 2F4; Mixed-Signal Hardware Desig n; data\Po; wer In; d Reg; lat; ors.S; Termi; nal Bl; ock; MBRS1; necto; +3V3Reg; ulato; +1V8Reg

Power Supply Page
