MaulikItaliya/Mixed-Signal-Board/Manufacturing_files/Assembly_Files/Bottom_Layer_Assembly.PDF

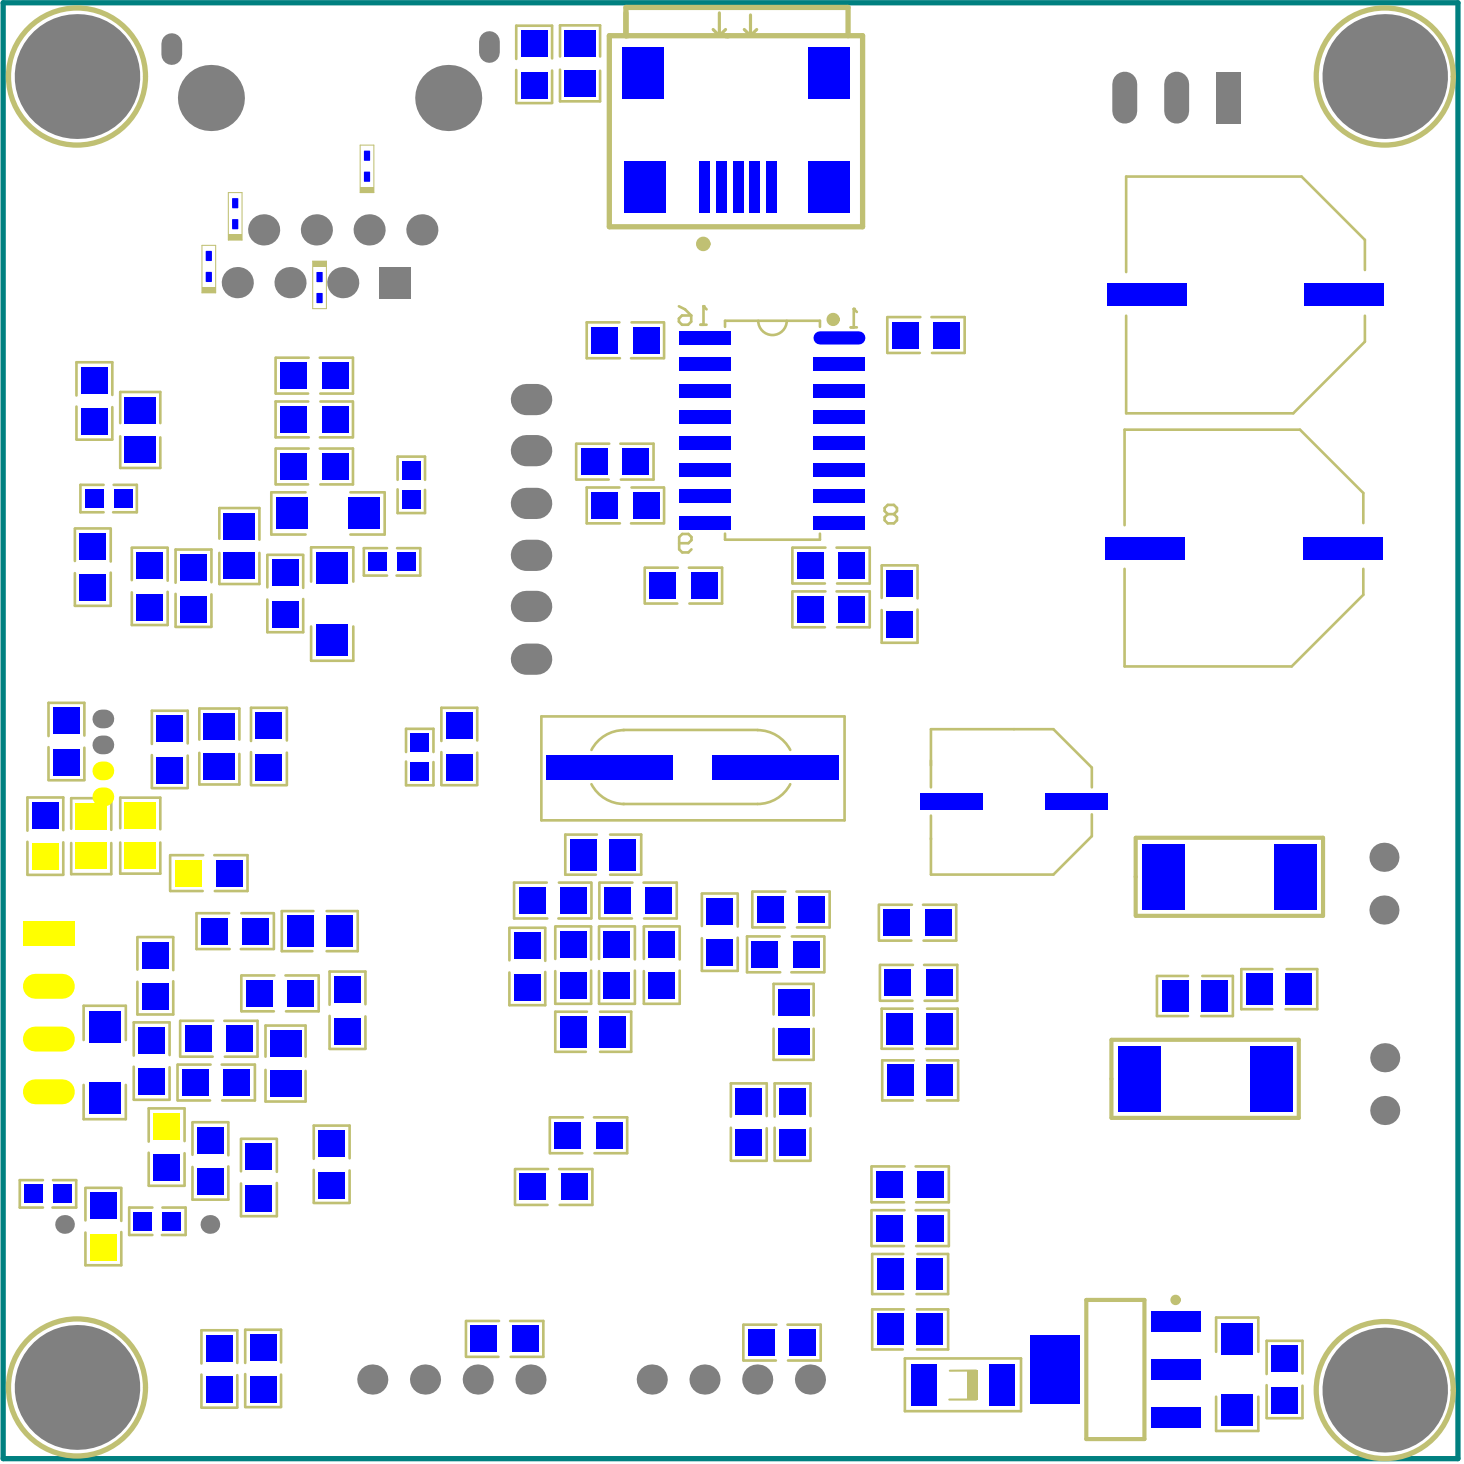
[picture p19: page 1]
