MaulikItaliya/Mixed-Signal-Board/Manufacturing_files/Assembly_Files/Top_Layer_Assembly.PDF

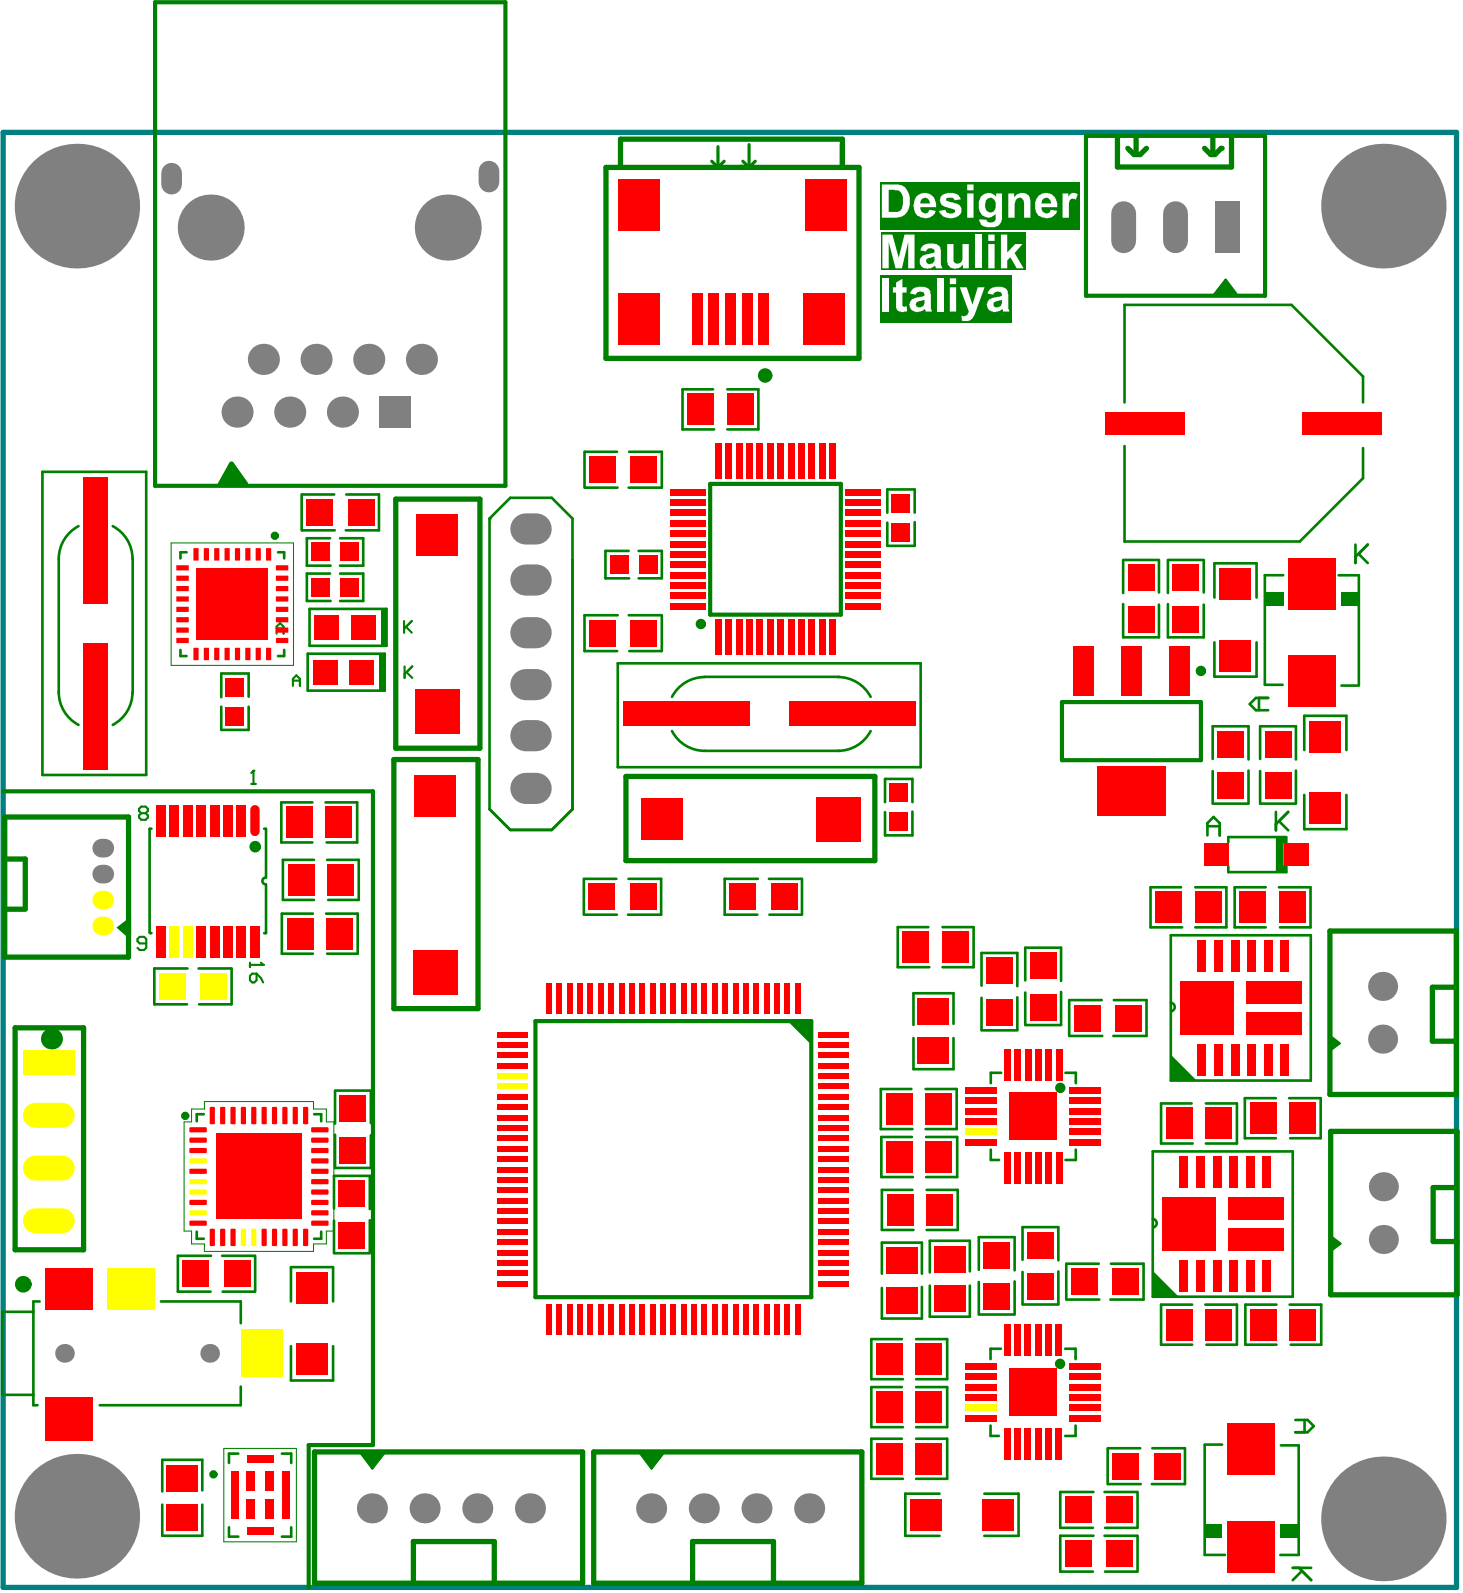
[picture p20: page 1]
