MaulikItaliya/Mixed-Signal-Board/Documentation/PCB/Bottom_Layer_Assembly+signalPCB.pdf

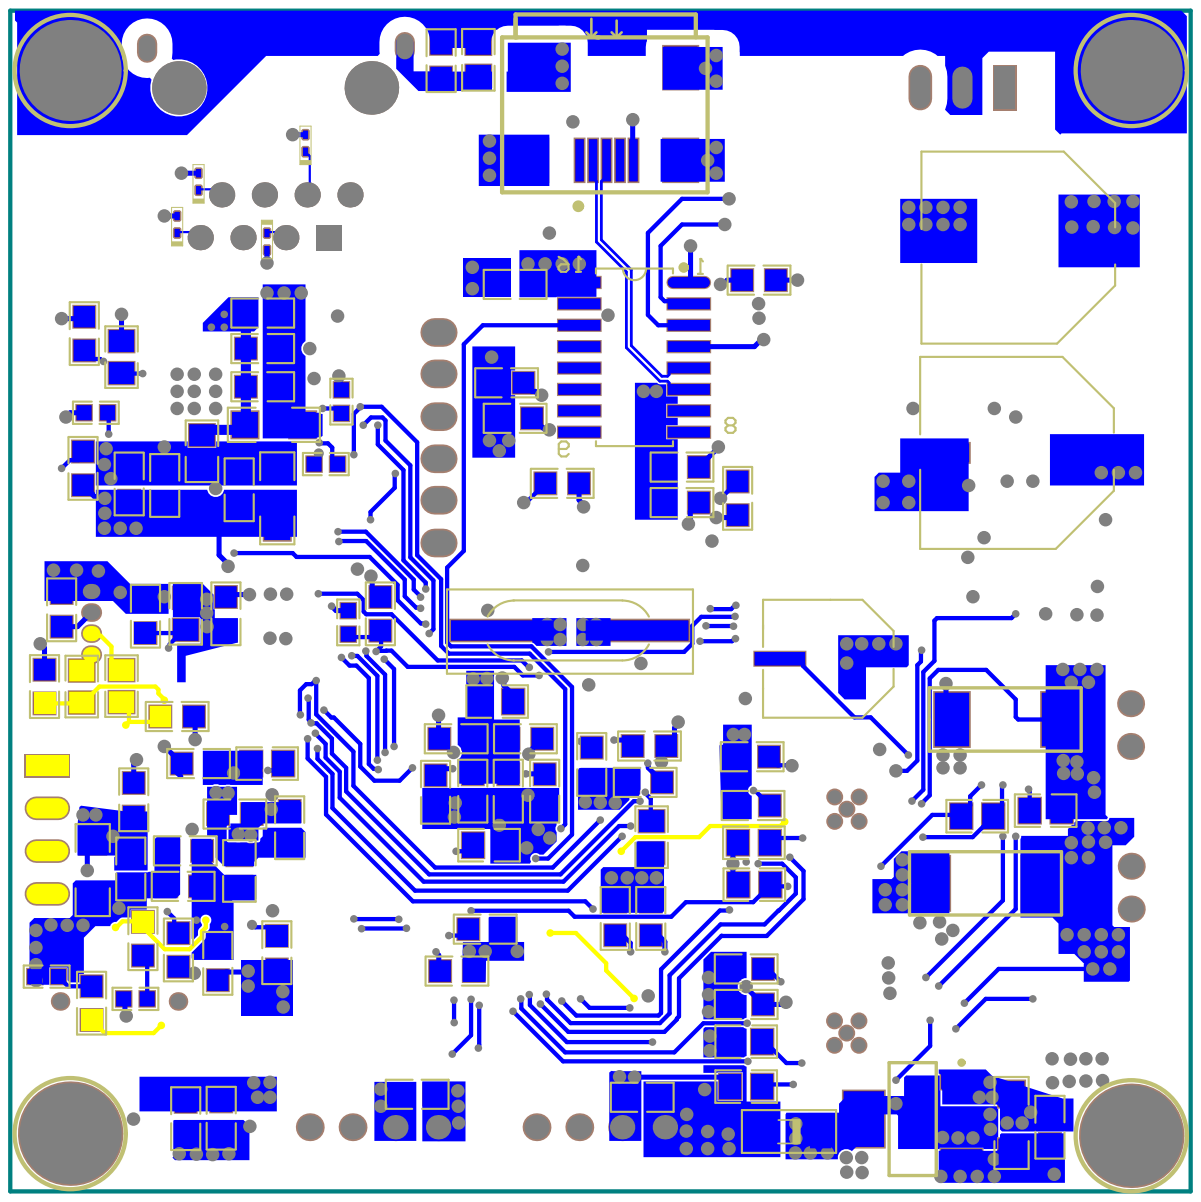
[picture p21: page 1]
