MaulikItaliya/Mixed-Signal-Board/Documentation/PCB/Top_&_Bottom_Assembly_&_Signal.PDF

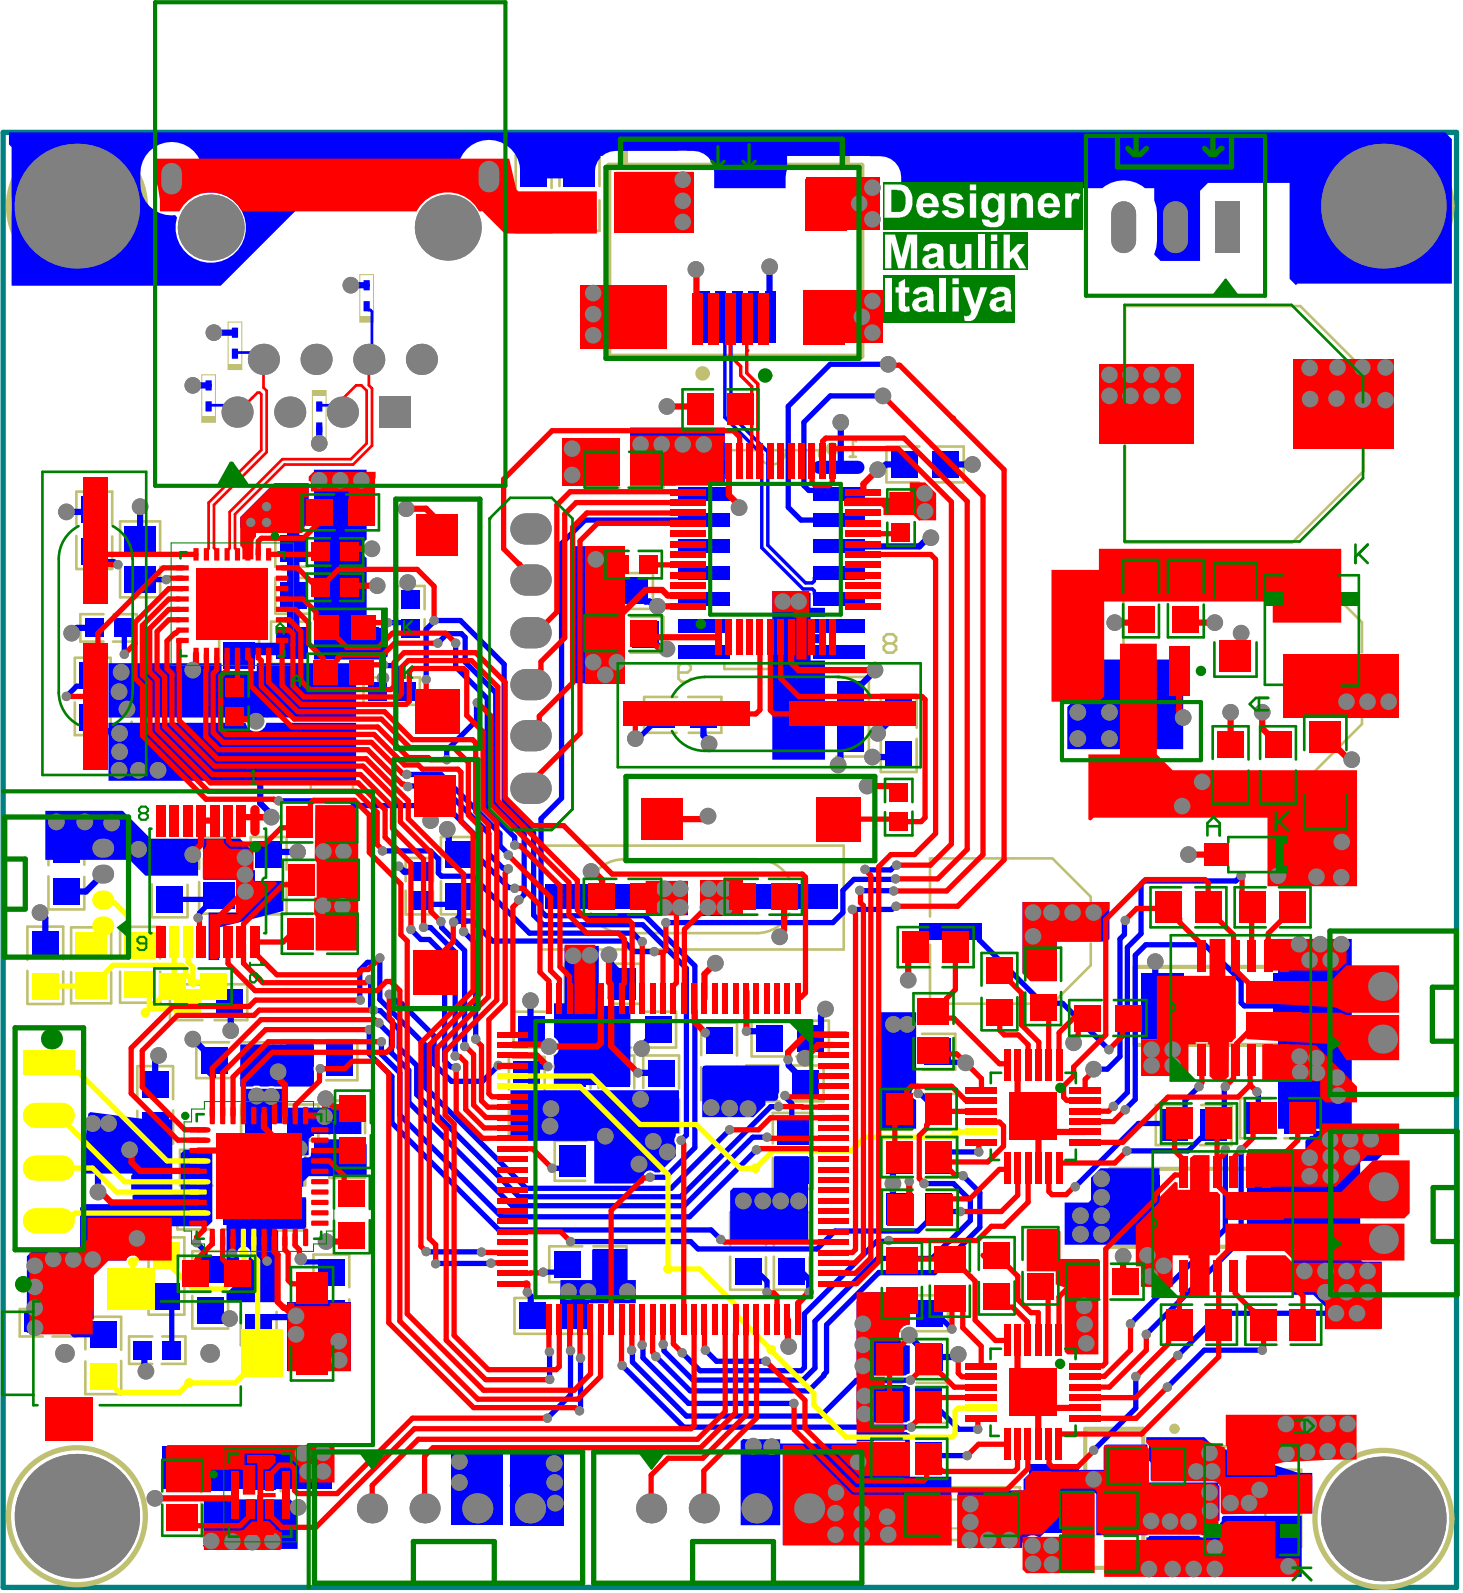
[picture p22: page 1]
