MaulikItaliya/Mixed-Signal-Board/Documentation/PCB/Top_Layer_Assembly+SignalPCB.pdf

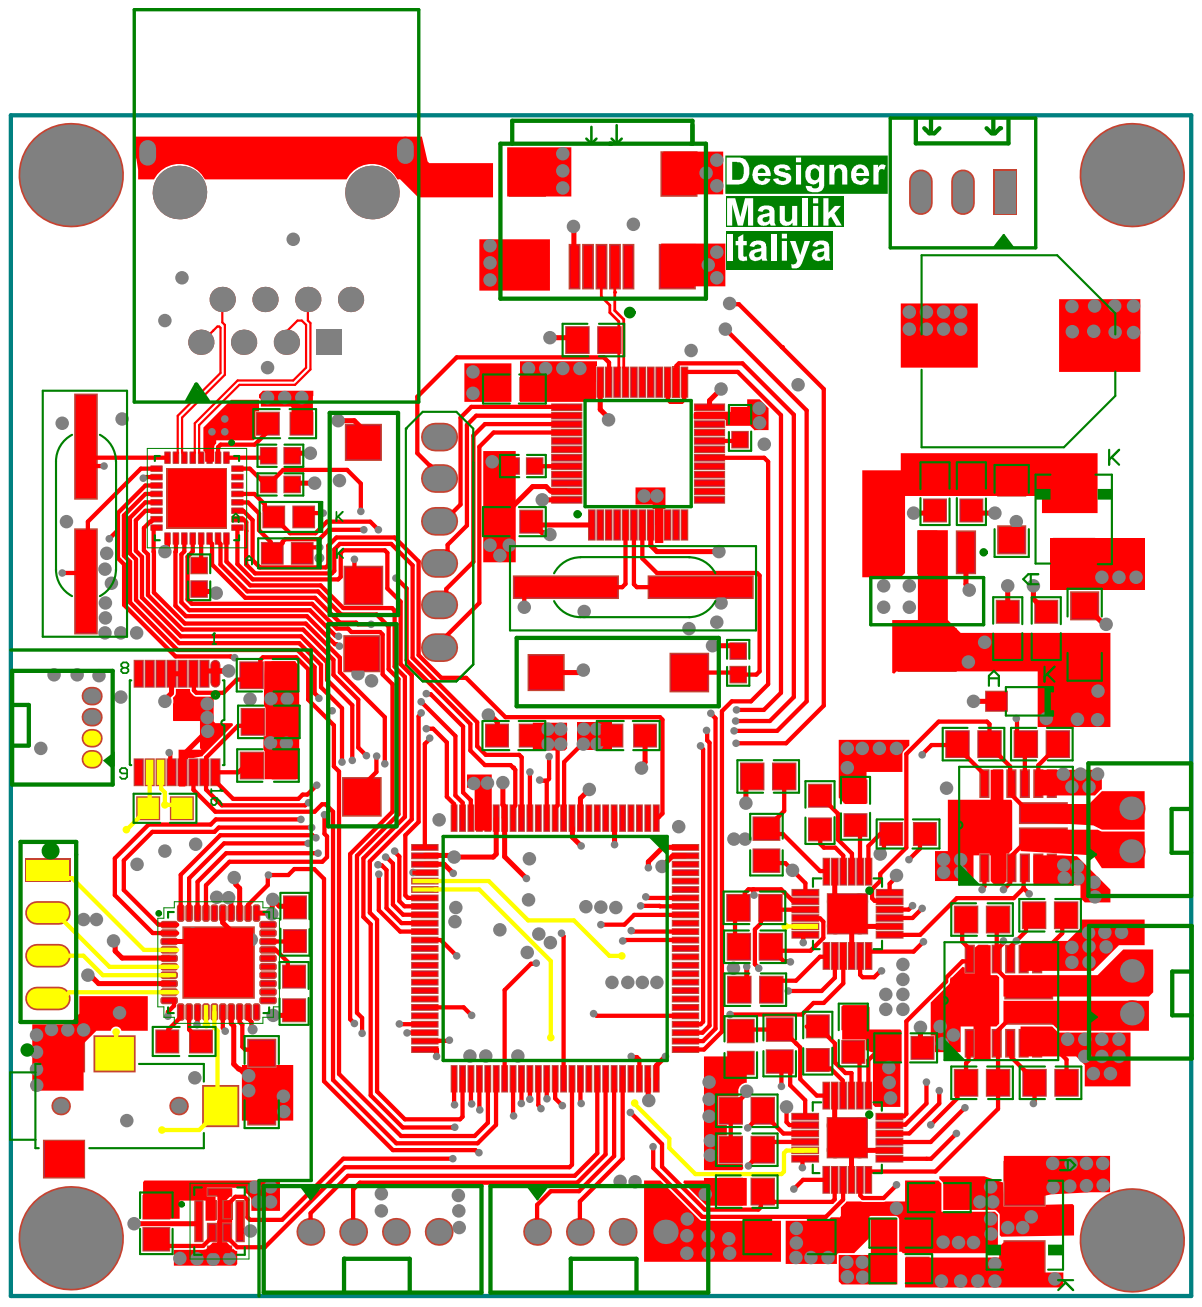
[picture p23: page 1]
