MaulikItaliya/Mixed-Signal-Board/Documentation/PCB/GND_Plane.pdf

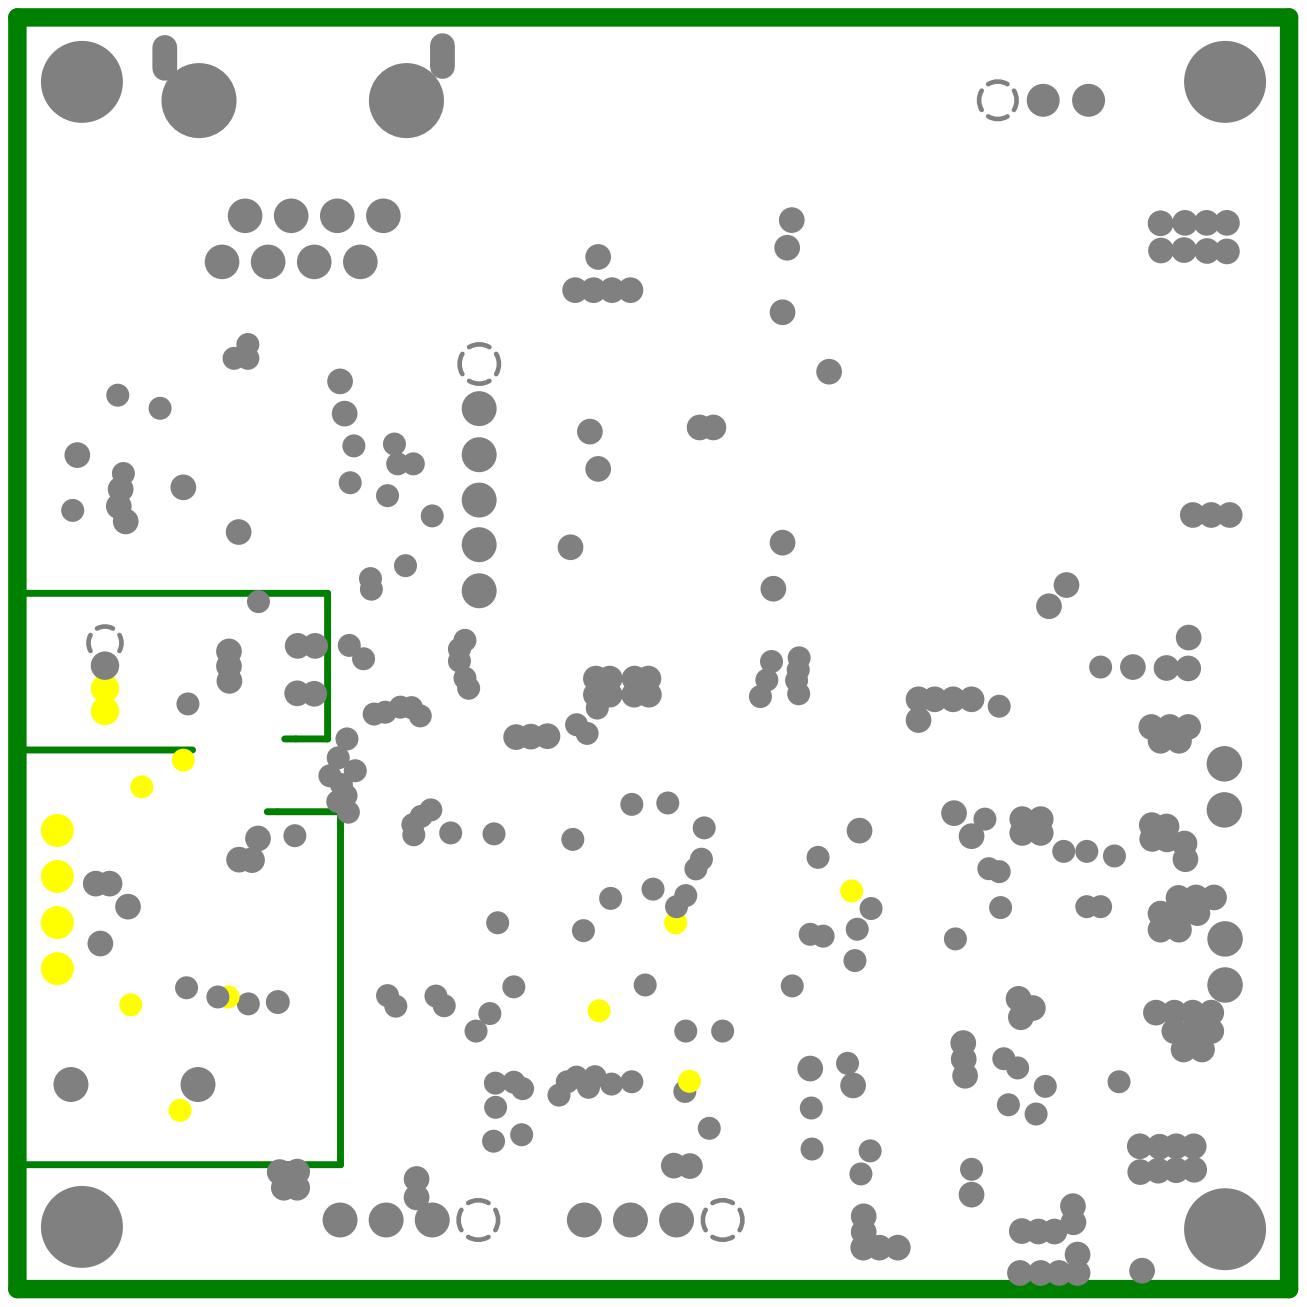
[picture p24: page 1]
