MaulikItaliya/Mixed-Signal-Board/Documentation/PCB/Power_Plane.pdf

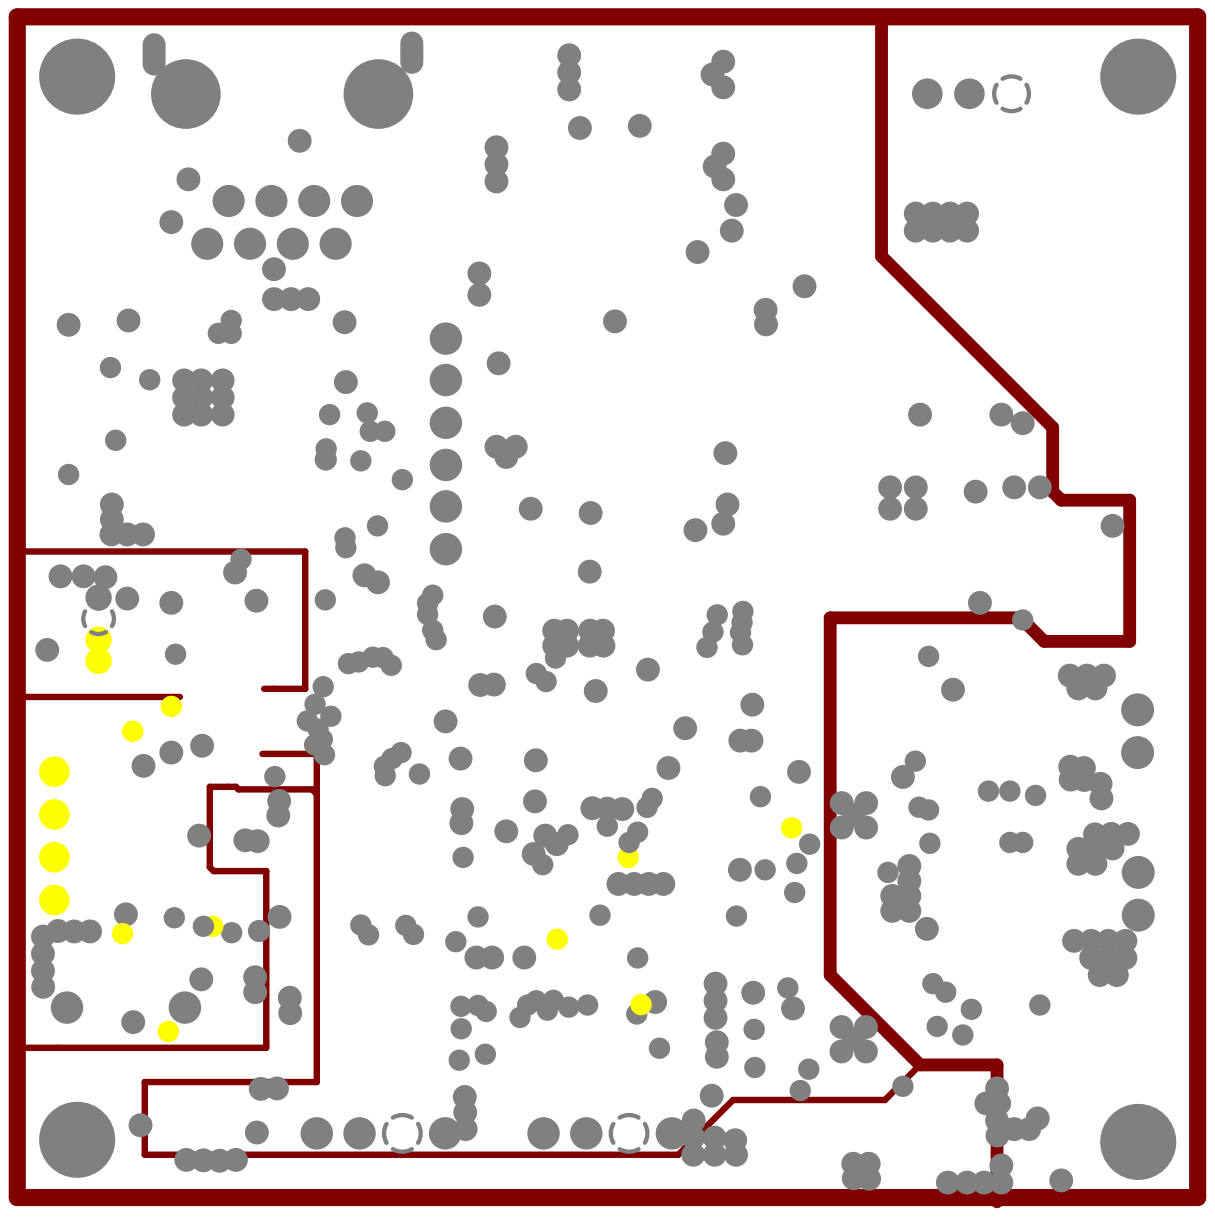
[picture p25: page 1]
