MaulikItaliya/Mixed-Signal-Board/(commit log)

2026-10-06 Add files via upload
    Add complete 11-page schematic documentation
2026-10-07 Add files via upload
    Add PCB layer and 3D documentation
2026-10-07 Update README.md
    ADDED PCB documentation part
2026-10-09 Add files via upload
    GND & Power Plane added
2026-10-10 Add files via upload
    Added BOM file
    [Mixed_Design_Board_DigiKey__BOM.xlsx]
2026-10-12 Add files via upload
    Added Gerber files
2026-10-13 Add files via upload
    Added NC drill files
2026-10-14 Add files via upload
    Added Assembly files
